250888/fpga2026-42161/doc/photous/动态，实物图.jpg

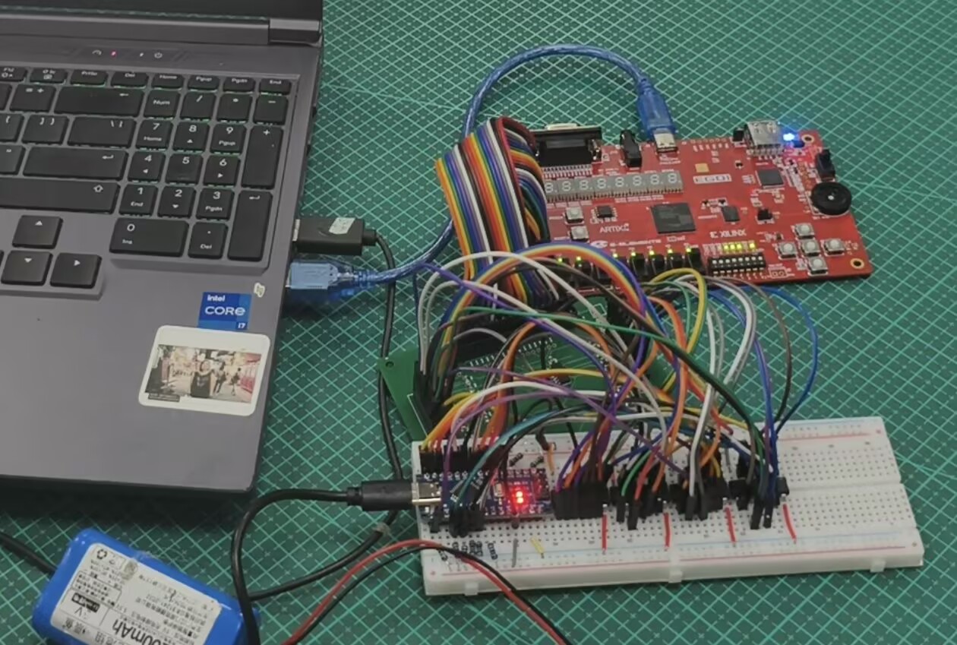
doc/photous/动态，实物图.jpg
