250888/fpga2026-42161/doc/photous/fpga.jpg

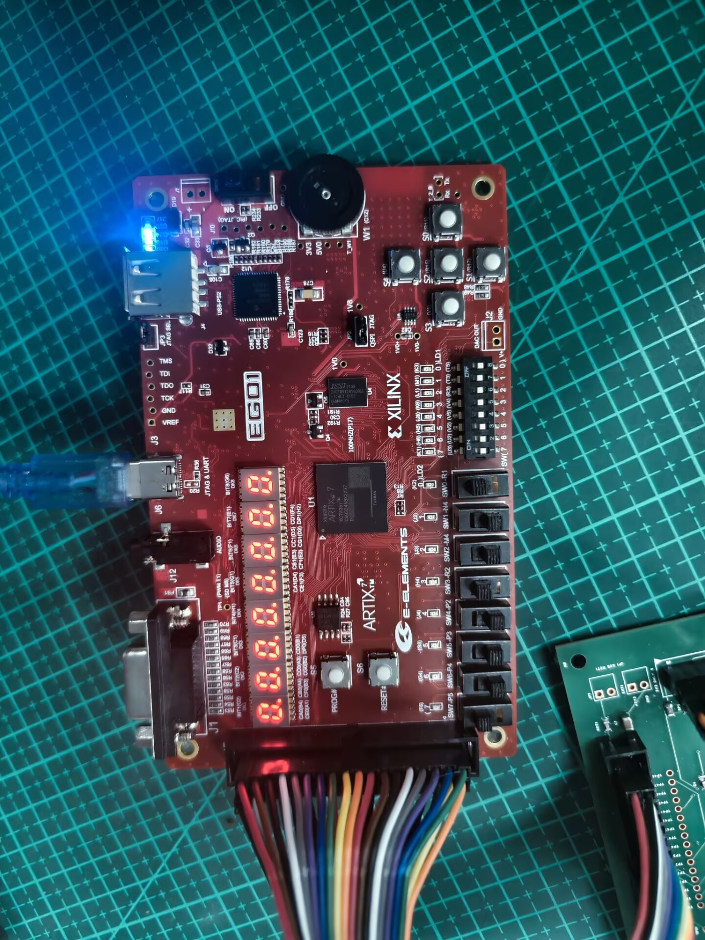
doc/photous/fpga.jpg
