250888/fpga2026-42161/doc/reports/2026-10-11-j5-pin-review/README.md

# J5 上板前逐针复核签字记录（§27-GO）

- **日期**：2026-10-11
- **结论：通过（GO）——四方 36/36 全一致，0 差异**
- **依据**：AGENTS §6 红线 6「上板前 J5 必须按 EGO1 V2.2 官方手册逐针复核（§27-GO），并留勾选记录」；
  用户已授权执行本复核（2026-10-11 拍板：「用它做 J5 上板前逐针复核签字」）。
- **复跑命令**：`D:/Embedded/Python/python.exe check_j5_pins.py`（本目录，需 python-docx + pypdf；
  任何一项不一致即退出码 1）。本次运行输出见 `check_output.txt`。

## 1. 四方基准

| # | 源 | 文件 | 权威性说明 |
|---|----|---|---|
| ① | **EGO1 V2.2 官方手册** | `资料/EGO1板卡/Ego1_UserManual_v2.2.pdf`（21 页，封面「2018.04 ver2.2 依元素科技」，J5 表在 p20–21） | 红线 6 指名基准；2026-10-11 经 ghfast.top 镜像自官方开发包公开副本归档 |
| ② | 南邮 eelab 转存件 | `资料/EGO1板卡/EGo1_用户手册_18页.pdf` + 同名全文提取 txt（J5 表 p17–18） | 网页转存（2018-09-18 打印），**无版本标记**；与 ① 逐项同，作交叉件 |
| ③ | V1.9 §4.1 表3 | `doc/瞬迹_完整可行技术路线_EGO1开发板版_V1.9.docx` tables[3] | 项目唯一技术基线（36 针全表） |
| ④ | 实施约束 | `constrs/ego1.xdc`（J5 段，行 30–67） | P0 按表3 重写的落地文件 |

## 2. 逐针勾选表（36/36 ✓，完整输出见 check_output.txt）

判定规则：1–32 针 = 四方 ball 全等 ∧ 两手册原理图标号相等 ∧ 表3「项目信号」含规定端口 ∧
XDC 端口/ball 对号（1–16→`a_ctrl_n[0..15]`，17–32→`b_raw[0..15]`）；
33–36 针 = 两手册与 XDC 均无此针 ∧ 表3 记 GND/3.3V。另查全文件无重复 `PACKAGE_PIN`。

| 针 | 原理图标号 | Ball | 端口 | ①V2.2 | ②南邮 | ③表3 | ④XDC | 勾选 |
|----|---|---|---|:---:|:-----:|:----:|:----:|:----:|
| 1 | AD2P_15 | B16 | a_ctrl_n[0] | ✓ | ✓ | ✓ | ✓ | ☑ |
| 2 | AD2N_15 | B17 | a_ctrl_n[1] | ✓ | ✓ | ✓ | ✓ | ☑ |
| 3 | AD10P_15 | A15 | a_ctrl_n[2] | ✓ | ✓ | ✓ | ✓ | ☑ |
| 4 | AD10N_15 | A16 | a_ctrl_n[3] | ✓ | ✓ | ✓ | ✓ | ☑ |
| 5 | AD3P_15 | A13 | a_ctrl_n[4] | ✓ | ✓ | ✓ | ✓ | ☑ |
| 6 | AD3N_15 | A14 | a_ctrl_n[5] | ✓ | ✓ | ✓ | ✓ | ☑ |
| 7 | AD11P_15 | B18 | a_ctrl_n[6] | ✓ | ✓ | ✓ | ✓ | ☑ |
| 8 | AD11N_15 | A18 | a_ctrl_n[7] | ✓ | ✓ | ✓ | ✓ | ☑ |
| 9 | AD9P_15 | F13 | a_ctrl_n[8] | ✓ | ✓ | ✓ | ✓ | ☑ |
| 10 | AD9N_15 | F14 | a_ctrl_n[9] | ✓ | ✓ | ✓ | ✓ | ☑ |
| 11 | AD8P_15 | B13 | a_ctrl_n[10] | ✓ | ✓ | ✓ | ✓ | ☑ |
| 12 | AD8N_15 | B14 | a_ctrl_n[11] | ✓ | ✓ | ✓ | ✓ | ☑ |
| 13 | AD0P_15 | D14 | a_ctrl_n[12] | ✓ | ✓ | ✓ | ✓ | ☑ |
| 14 | AD0N_15 | C14 | a_ctrl_n[13] | ✓ | ✓ | ✓ | ✓ | ☑ |
| 15 | IO_L4P | B11 | a_ctrl_n[14] | ✓ | ✓ | ✓ | ✓ | ☑ |
| 16 | IO_L4N | A11 | a_ctrl_n[15] | ✓ | ✓ | ✓ | ✓ | ☑ |
| 17 | IO_L11P | E15 | b_raw[0] | ✓ | ✓ | ✓ | ✓ | ☑ |
| 18 | IO_L11N | E16 | b_raw[1] | ✓ | ✓ | ✓ | ✓ | ☑ |
| 19 | IO_L12P | D15 | b_raw[2] | ✓ | ✓ | ✓ | ✓ | ☑ |
| 20 | IO_L12N | C15 | b_raw[3] | ✓ | ✓ | ✓ | ✓ | ☑ |
| 21 | IO_L13P | H16 | b_raw[4] | ✓ | ✓ | ✓ | ✓ | ☑ |
| 22 | IO_L13N | G16 | b_raw[5] | ✓ | ✓ | ✓ | ✓ | ☑ |
| 23 | IO_L14P | F15 | b_raw[6] | ✓ | ✓ | ✓ | ✓ | ☑ |
| 24 | IO_L14N | F16 | b_raw[7] | ✓ | ✓ | ✓ | ✓ | ☑ |
| 25 | IO_L15P | H14 | b_raw[8] | ✓ | ✓ | ✓ | ✓ | ☑ |
| 26 | IO_L15N | G14 | b_raw[9] | ✓ | ✓ | ✓ | ✓ | ☑ |
| 27 | IO_L16P | E17 | b_raw[10] | ✓ | ✓ | ✓ | ✓ | ☑ |
| 28 | IO_L16N | D17 | b_raw[11] | ✓ | ✓ | ✓ | ✓ | ☑ |
| 29 | IO_L17P | K13 | b_raw[12] | ✓ | ✓ | ✓ | ✓ | ☑ |
| 30 | IO_L17N | J13 | b_raw[13] | ✓ | ✓ | ✓ | ✓ | ☑ |
| 31 | IO_L18P | H17 | b_raw[14] | ✓ | ✓ | ✓ | ✓ | ☑ |
| 32 | IO_L18N | G17 | b_raw[15] | ✓ | ✓ | ✓ | ✓ | ☑ |
| 33 | GND | （电源针，不写 XDC） | — | — | — | ✓ | — | ☑ |
| 34 | GND | （电源针，不写 XDC） | — | — | — | ✓ | — | ☑ |
| 35 | 3.3V | （电源针，不写 XDC） | — | — | — | ✓ | — | ☑ |
| 36 | 3.3V | （电源针，不写 XDC） | — | — | — | ✓ | — | ☑ |

补充核对：`constrs/ego1.xdc` 全文件无重复 `PACKAGE_PIN`；行 115 的 `PACKAGE_PIN J5` 是
led[4] 的**封装球位**（Artix-7 球名恰为 J5），与 J5 连接器无关，不构成冲突。

## 3. 版本自证（原缺口① → 已闭环）

- 南邮转存件全文 0 处版本字样（18 页逐一检索 `V2.2/版本/revision/version` 无命中），
  第 1 页为网页版式「Docs » EGo1用户手册」，PDF 元数据 = 2018-09-18 浏览器打印——**该件本身无法自证版本**。
- 「EGO1 V2.2 用户手册」的**直接证据**（2026-10-11 检索）：
  1. 依元素官方文档站 <https://e-elements.readthedocs.io/zh/ego1_v2.2/>——路径 `ego1_v2.2`、
     标题「EGo1 2.2 文档」，源分支 `AJetfire/EES@EGo1_V2.2`（api.github.com 分支列表可见）；
  2. 官方开发包手册 PDF 封面逐字「EGO1 用户手册 / 2018.04 ver2.2 / 依元素科技有限公司」——
     已归档为本目录 §1 的源①（`Ego1_UserManual_v2.2.pdf`，21 页，WPS 原生 PDF，创建于 2018-07-02）。
- 交叉验证：v2.2 正式版 J5 表与南邮转存件 **32/32 逐项全同**（网络标号+封装球位），
  即此前基于南邮件的核对结论对 v2.2 同样成立；本记录的比对更以 v2.2 件**直接参与**四方比对。

## 4. 33–36 电源针佐证（原缺口② → 已闭环）

- 手册文字层只覆盖 1–32（v2.2 与南邮件均写「共提供 32 个双向 IO」，表止于 32）；
  全网检索亦无任何以文字写出「33/34=GND、35/36=3.3V」的公开正文。
- **原理图级证据**：官方开发包《EGO1電路圖.pdf》第 6 页（SHEET 6 OF 10，TITLE: IO，E-ELEMENTS）
  的 `J5 / 2X18P-B` 连接器：
  - pin 35（右上）与 pin 36（左上）→ 左右各一支 `+3.3V` 电源箭头；
  - pin 33（右二）与 pin 34（左二）→ 两侧竖轨下行汇合 → 标准接地符号；
  - pin 1–32 网络标号（AD2P_15…IO_L18N/P）与手册表逐项一致。
  该页已渲染放大目验（2026-10-11），PDF 已归档：`资料/EGO1板卡/EGO1电路图_官方开发包.pdf`。
- 故 V1.9 表3 的「33/34=GND、35/36=3.3V、备注不写 XDC」与 XDC 现状（无 33–36 条目）**成立**。

## 5. 遗留缺口（不阻塞本次 GO）

1. **依元素「EGo1-开发包 v1.61」需注册登录下载**（<http://www.e-elements.com/>，登录须本人操作）——
   当前证据链已由「官方文档站 + 官方开发包公开副本」闭合，此项降级为可选复核。
2. 手册文字层无 33–36 表述（以原理图级证据替代）；若需文字级，可在登录下载官方开发包后再核一次。

## 6. 签字栏

| 角色 | 结果 | 日期 | 签名 |
|---|---|---|---|
| 复核执行（AI 协作者，四方程序化比对 + 原理图目验） | GO | 2026-10-11 | （电子记录即本文件） |
| 用户确认（上板前最终签字） | 待签 | | |
