250888/fpga2026-42161/doc/实施计划.md

# 瞬迹 — 实施计划（阶段一启动）

> ⚠ 本文件依据旧版 V1.2；**决策以 `瞬迹_完整可行技术路线_EGO1开发板版_V1.9.docx` 为准**（见 `../AGENTS.md` §1）。  
> 日期：2026-09-14｜最近更新：2026-10-02（见文末重组记录）

## 三件事对照

| 项 | 内容 | 状态 |
|----|---|---|
| A | EGO1 Vivado 工程（xc7a35tcsg324-1，100MHz P17，J5 约束，UART T4/N5） | ✅ 综合/实现/bitstream 完成 |
| B | 下单物料（LVC07 / LVC14 / 4066 / 电阻电容 / IDC20 / 排线） | **待人工下单** |
| C | 4路 GPIO 自回环 RTL（拓扑扫描 + Timestamp + UART） | ✅ 仿真 PASS |

### 已完成（2026-09-14）

- 仿真：4 路交叉拓扑矩阵正确
- 比特流：`瞬迹/vivado/xj_top.bit`（LUT 149 / FF 197 / 时序收敛）
- XDC：部分无效 J5 管脚已修正；**上板前仍需对照 EGO1 手册核对**
- 注意：请在英文路径 `D:\xunjiji` 下跑 Vivado（中文路径会导致工具异常）

## 立刻要做

1. **官网报名**（截止 2026-09-22 24:00）— 最优先
2. **下单**第一批物料（见技术路线采购清单）
3. **对照 EGO1 V2.2 手册**核对 `constrs/ego1.xdc` 中 J5 引脚
4. 物料到货后：跳线 A0→B2, A1→B0, A2→B3, A3→B1，烧录 `xj_top.bit`
5. 串口 115200 抓 `A5 5A ...` 帧验证拓扑

## 阶段一验收标准

- [x] 仿真：4 路任意交叉，拓扑矩阵正确
- [ ] 上板：跳线 A0→B2, A1→B0, A2→B3, A3→B1
- [ ] UART 115200 收到 `A5 5A ...` 帧，矩阵与跳线一致
- [ ] 拔掉一根线：对应 open_flags 置位
- [ ] LED 指示扫描中 / 完成状态正确

## 阶段二预告

- 4 路静态故障注入（OPEN / MISWIRE）
- 前端 1 路物理链路（LVC07 + LVC14 + 上拉实验）
- 确认后再扩 16 路 PCB

## 风险

| 风险 | 处理 |
|---|---|
| J5 引脚表不准 | 上板前用手册/万用表核对；先只信 A[3:0]/B[3:0] |
| LVC14 反相 | RTL 侧已用「驱动低 → B 读低」约定；若实测反相，在 `input_sync` 后取反 |
| 报名未完成 | **最优先**，8 天内截止 |

---

## 重组记录（2026-10-02）

按用户指令完成项目清理与 uv 包化重组（原顶层工作区弃用，正式仓库 = 本目录）：

1. **结构**：RTL/TB 从 `src/` 提升到仓库根 `rtl/`、`sim/`；旧 Vivado 工程移入 `vivado/legacy/`；V1.9 基线、HANDOFF、抽取工具、阶段一报告归档进 `doc/`。
2. **uv 包**：`src/xunji`（`protocol.py` UART 帧 = V1.9 §17 冻结规格；`cli.py` = `xunji sync` 镜像构建目录），15 项 pytest **全绿**（TDD 红→绿）。
3. **规范**：新增根级 **`AGENTS.md`**（基于 superpowers 技能族：using-git-worktrees / writing-plans / executing-plans / TDD / systematic-debugging / verification-before-completion / finishing-a-development-branch / 评审技能）。
4. **Git**：本目录重新 `git init`，本地服务仓库 `git_server/`（remote=`origin`）。
5. 弃用旧目录移至 `../_archive_deprecated/`（保留不删除，附 README）。

**待办不变**：P0 —— EGO1 手册逐针复核表3 → 重写 XDC → 顶层 wrapper 对齐（见 `../README.md`）。
→ 代码侧已于 2026-10-08 完成，见下节；剩余为手册复核与板载 I/O 冻结决策。

---

## P0 记录（2026-10-08）

分支 `p0-xdc-wrappers`（worktree `.worktrees/p0-xdc-wrappers/`）；计划
`doc/superpowers/plans/2026-10-08-p0-xdc-wrappers.md`；TDD 红→绿，逐任务提交。

1. **XDC 重写**：`constrs/ego1.xdc` 冻结段 1–6 逐字对齐 V1.9 §4.2；J5 32 路针脚按
   §4.1 表3（废除旧草稿的 N18/L17 非法脚与试错脚）；`a_ctrl_n[*]` DRIVE 4 + SLEW SLOW；
   UART `uart_tx→T4`、`uart_rx→N5`；`create_clock -period 10.000`。
   板载 LED/按键/拨码为**暂定段**（V1.9 §4.2 未冻结 = HANDOFF §4.3 遗留1），待文档拍板。
   红线测试 `tests/test_xdc.py`（7 项，含全表无重复针）。
2. **顶层对齐**：`xunji_top_hw`（`b_conn=b_sync`，合成顶层）/ `xunji_top_loopback`
   （`b_conn=~b_sync`，仿真顶层，**全工程唯一反相点**）/ 共享 `xunji_core`（只读 `b_conn`，
   不再读 `b_raw`）。新增 `xj_rst_sync`（V1.9 §4.2 P030 原文实现）；`input_sync` 补
   `ASYNC_REG`/`SHREG_EXTRACT`；`topology_scanner` 去掉内部 `~b_filtered`。
   TB 改名 `tb_xunji_loopback` 并加极性交叉断言；红线测试 `tests/test_top.py`（8 项）。
3. **验证（本次会话实跑）**：`uv run pytest -q` → 41 passed；`uv run xunji lint` →
   两个顶层均 exit 0；`uv run xunji sim` → PASS（矩阵 = EXPECT）。
   变异检查：把 loopback 的 `~` 去掉 → sim 立刻 FAIL（exit 1），恢复后 PASS，证明断言真会咬。
   **`uv run xunji xsim` 阻塞**：本机 Vivado 2024.2 的 `xvlog.exe` 唯一缺失导入
   `xv_xsimverific.dll`（产品 `lib/win64.o` 载荷整体缺失），C:/D:/E: 全机无此文件也无安装包
   → 离线不可修，需重装或从完好机器拷 `Xilinx`。
4. **P0 仍未完成**：① EGO1 V2.2 手册 §14 逐针复核表3 并留勾选记录（工作区无手册 PDF）；
   ② 板载 LED/按键约束的冻结决策；③ `b_raw`→第一级同步器 D 端的 path exception
   （须 Vivado `report_cdc` 复核目标数 =16 后再写，宁可暂留未约束告警）。
5. **刻意不动**：`N_CH` 默认仍为 4（扩 16 路连同 P1 扫描重构与 TB 扩展一起做，避免
   未验证的行为变更）；`topology_scanner` 状态机/时序参数/矩阵位序不变；`uart_packet_tx`
   帧协议遗留不变。

## FE-16 PCB 记录（2026-10-12）

用户「开始画pcb」指定 V1.9 docx 方案，EDA 决策全权委托（四问确认：SOIC-14 / 全 0805 /
装 KiCad / 板框 160×90 四孔）。产出 `pcb/frontend16/`：

1. **流水线**：`run_pipeline.py` = gen_frontend16 → gen_dsn → Freerouting 2.5.0（JAR+JRE25
   绕行 native 启动 bug #957）→ route_ses → pytest(12)。最终 1437 段 / 154 过孔 / 84 网 / score 1000。
2. **净距线宽链**：Freerouting 拥塞走廊会把线收窄到 0.75/0.6/0.5 mm 阶梯（`automatic_neckdown`
   开关管不到的第三机制）→ route_ses 统一回写 0.25；DSN 规划净距取 0.27（0.2 要求 + 两侧各
   0.0626 半宽增量）保证抬宽后仍 ≥0.2；IDC/排针 pin1 独立方 padstack（方角比圆多伸 0.29mm，
   按圆建模会漏 shorting_items）。
3. **符号坐标**：KiCad 符号库 y 轴向上（渲染 y = Y − ly），lib 定义与标签表同步取负 y →
   引脚 1/VCC 顶置、GND 底置；连接器奇左偶右，符号行 = `pads_idc` 列对式排线物理列；
   连接器 pin name 隐藏（`~`）只留 number 避免与标签叠字；`_pin_abs` 负责标签落点跟随。
4. **验证（会话实跑）**：kicad-cli 10.0.7 DRC 0 / ERC 0（`xunji_fe16.kicad_pro` 仅
   lib_* / endpoint_off_grid 三类 ignore，真问题保持报错）；`uv run pytest -q` 61 passed；
   PCB 输出哈希验证为确定性，符号改动零影响布线（前后字节一致）。三视图目检 `doc/FE16预览.html`。
5. **提交**：1ab55a3（全套）+ fc083de（预览页/SVG），未推送（推送待用户拍板）。
   遗留：spec D10 线宽/铺铜与 JP1 脚数两处文档回填；`demo_*.rpt` 工作树残留未删。

## FE-16 改板 96×96 记录（2026-10-13）

用户「要直接能打板的最终 pcb，最好 <10×10cm，嘉立创可用免费券」→ 板框 160×90 → **96×96 mm**。
网表/位号/BOM 不变，仅几何重排：J5 顶中 (26.4,6.5)、JB 镜像 x=85.73、IC 以 x=48 对称、
电源区挪 J5 右侧顶角 (77/84, 6.5..13.5)、RP 列 x=77.5、TP 行 y=77/83/17、四角 φ3.2 随板框。
改动面：`fe16_design.py` / `gen_frontend16.py` / `fe16_router.py` / `gen_dsn.py`（boundary 动态）/
`tests/test_frontend_pcb.py`（分区断言改相对坐标）。

1. **丝印修复**：TP1..16 位号下置（+2）——上置会探进 C3/C6 焊盘/丝印（silk_over_copper/
   silk_overlap 各 4 条 warning），下置后 --severity-all 0 violation。
2. **复跑管线**：freerouting 0 unrouted 0 violations → 1903 段 / 164 过孔 / 84 网（回填加宽 114 处）；
   pytest 12 passed；kicad-cli DRC --severity-all **0 violation / 0 未连接**。
3. **交付**：`xunji_fe16_gerber_96x96.zip`（F/B Cu+Mask+Silk+Paste、Edge.Cuts、job、Excellon
   mm 钻孔 0.3/1.0/3.2 三孔径，共 11 文件），嘉立创直接上传；下单留用户拍板。
4. LCEDA 云端路径弃用：保存零流量、重载树空 boards=[]，定性不可用。

## P1 静态核心 T1：四阶段扫描（2026-10-22）

分支 `p1-static-core`（worktree `.worktrees/p1-static-core/`，基线 `686848b`）；计划
`doc/superpowers/plans/2026-10-22-p1-static-core.md`。TDD：TB 先红（`parameter GUARD_STABLE not found`）→ 实现 → 绿。

1. **FSM（`rtl/topology_scanner.v`，= V1.9 R6 static_sampler）**：IDLE → IDLE_CHECK → 每通道
   DRIVE → SETTLE(500) → SAMPLE(101 拍逐位计票) → DECIDE（票数 > 50 且非卡低才判连接）→
   RELEASE/GUARD（b_conn 全 0 连续 8 拍；500 拍超时置 release_timeout）→ NEXT ×N_CH → DONE（算 open_flags）。
   新增输出 `stuck_low_mask` / `idle_ok` / `release_timeout`；IDLE_CHECK 若有通道为 1，
   只记 mask 并在矩阵中强制该列为 0（V1.9「禁止当成正常连接边」）。
2. **TB（`sim/tb_static_sampler.v`）**：参数取小值加速，四场景 —— 正常交叉矩阵（位序 = V1.9 P059）、
   采样窗内 1 拍毛刺免疫、空闲卡低（mask=1000/idle_ok=0/该列强制 0）、释放后卡高（release_timeout=1）。
3. **接线**：`xunji_core` 接新输出并重排 LED 语义（[3]idle_ok [4]release_timeout [5]卡低 [6]任一开口）。
   **N_CH 保持 4**：uart_packet_tx 仍是 4×4/4B 载荷，4→16 必须与 §17 载荷扩展同批（T2/T3）。
4. **验证（本次实跑）**：pytest **66 passed**；lint 双顶层 exit 0；sim 三 TB PASS；
   xsim 2026.1 终审三 TB PASS。红线测试 `tests/test_static_sampler.py`（默认参数/阶段/输出/多数表决/注册 5 项）。
5. 调试插曲：`S_DONE = 3'd8` 被截断为 0（状态 4 位）导致 done 永不发；TB start 单拍与 DUT 采样竞争
   → 改 `4'd8` 与 start 保持 3 拍。

## P1 静态核心 T2：Golden Map 比较与 LEARN（2026-10-22）

1. **`rtl/matrix_degree.v`**：逐行/列统计连接度，输出 `a_eq1/a_gt1/a_zero`、`b_eq1/b_gt1/b_zero`
   与 `all_one`（全行列度均为 1），供 golden_compare 与 learn_gate 共用。
2. **`rtl/golden_compare.v`（V1.9 P060）**：`missing=M_ref&~M_test`、`extra=~M_ref&M_test`；
   分类优先级 PASS → BRIDGE（任一 deg>1）→ MISWIRE（缺失+额外并存且参考有效行/列实测度仍为 1，
   即双射换位，不限于两根互换）→ OPEN（只有缺失、缺失行实测全空）→ ANOMALY（其余混合）。
3. **`rtl/learn_gate.v`（V1.9 P059）**：LEARN 仅当 `idle_ok && all_one` 才写入 M_ref 并置
   `reference_valid=1`；否则拒绝（valid=0，M_ref 保持不变），避免学到坏参考。
4. **TB（`sim/tb_golden_compare.v`）**：PASS/OPEN/MISWIRE/BRIDGE/ANOMALY 五向量 + LEARN 接受/
   IDLE 拒绝/度非 1 拒绝三路径；分类枚举与 TB `C_*` 常量对齐。
5. **调试插曲**：xsim 下 TB 与 DUT 同 delta 更新 `m_scan`/`learn`，组合度标记未结算 → BRIDGE 被误接受；
   TB 在拉 learn 前加 1 ns 结算（硬件语义：矩阵稳定后才按 LEARN），iverilog 未暴露。清单测试改为
   「SIM_TOPS = sim/ 下全部 tb_*」自维护。
6. **验证（本次实跑）**：pytest **70 passed**；lint 双顶层 exit 0；sim 四 TB PASS；xsim 终审四 TB PASS。

## P1 静态核心 T3：16 路 + 拓扑帧载荷扩展（2026-10-22）

1. **文档定性**：V1.9 §17（P106）只冻结帧结构（SOF 55AA/Ver/Type/Len/Seq/Payload/CRC16，小端、CRC 参数），
   **payload 语义是工程决策**（原 4B 布局亦如此）。故本次不改 V1.9 docx，改为决策记录
   `doc/superpowers/specs/2026-10-22-topology-frame-16ch.md` 并经 protocol/TB 双向锁定。
2. **新 payload**：`MAT(N*N/8) + open(2,LE) + stuck(2,LE) + cls(1) + ts0(1)`；4 路 8B/帧 18B，
   16 路 38B/帧 48B；Type=1 与 CRC 不变；byte k = `matrix[8k+7:8k]`（与旧 mat_lo/mat_hi 顺序兼容）。
   cls：0 PASS / 1 OPEN / 2 MISWIRE / 3 BRIDGE / 4 ANOMALY / 5 NO_REF（未学习）。
3. **RTL**：`uart_packet_tx` 重写为 N_CH 通用（MAT_BYTES/PAYLOAD_LEN/BODY_LEN/FRAME_LEN 由 N_CH 推导，
   matrix 由逐字节 part-select 取），新增 `stuck_low_mask`/`cls` 输入；`xunji_core` 与双 wrapper 默认 N_CH=16；
   core 暂以 `cls=5`（NO_REF）上报，T4 接 golden_compare 后替换。
4. **验证**：pytest **75 passed**（新增 test_matrix_payload 5 项 + 黄金帧更新）；lint 双顶层 exit 0；
   sim 四 TB PASS（tb_uart_packet_tx 改 18B×2 帧线级解码 + 独立 CRC 复算）。
5. **环境阻塞（非代码）**：xsim 不可用 —— 应用控制策略拦截 xelab 生成的 `xsimk.exe`
   （`D:\xunjiji` / `C:\xjbuild` / `E:\d` 三处实测均「应用程序控制策略已阻止此文件」）。
   T1/T2 的 xsim 证据在该策略生效前已取得；本任务以 lint+iverilog 四 TB 收口，终审待策略放行后补跑。

## P1 静态核心 T4：core 集成 + 16 路综合（2026-10-22）

1. **core 接线**：实例化 `learn_gate`（`btn[1]` 上升沿 → `learn_pulse`，按住不重复学习）与
   `golden_compare`（`m_test=conn_matrix`、`m_ref=learn 输出`）；帧内 `cls = reference_valid ? cmp_cls : 5`，
   未学习上报 NO_REF，不伪装 PASS；LED[7] = reference_valid（已学习指示）。
2. **集成 TB（`sim/tb_static_cls.v`）**：正常线束扫描 → 按 LEARN 接受参考 → 切双射换位/开路/双连
   三种故障重扫 → 分别期望 MISWIRE/OPEN/BRIDGE → 回正常期望 PASS。
3. **lint**：learn_gate 只消费 `matrix_degree.all_one`，逐行/列明细输出按接口留白豁免。
4. **验证（2026-10-24 实跑）**：pytest **84 passed**；lint 双顶层 exit 0；iverilog **6 TB** PASS
   （新增 16 路 48B 帧 TB，含"发送中途改矩阵"快照回归；`xunji sim` 现返回 0）。
5. **16 路综合/实现（工作流 A，C:\xjbuild）**：bit 产出 **2,192,215 B**；
   LUT **2119 (10.19%)**、FF **1564 (3.76%)**、BRAM 0、DSP 0（**不含 ILA**）；
   WNS **+1.408 ns**、WHS +0.029 ns，**全部时序约束 met**。
   （注：旧记录的 LUT 173 / FF 240 / WNS +4.765 是 4 路版数字，已作废。）
6. **未完成**：xsim 终审（策略阻塞）；上板 4 路回环 → FE-16 16 路联调；报告 §27 GO 表回填。
