250888/fpga2026-42161/doc/superpowers/plans/2026-10-11-uart-frame-v19.md

# 计划：uart_packet_tx 帧协议对齐 V1.9 §17

> 日期：2026-10-11 ｜ 分支：`uart-frame-v19` ｜ 基线：main@24532b8（四层全绿）
> 触发：用户拍板「uart_packet_tx 帧协议 A5 5A/CRC8 需对齐 V1.9 §17 的 55 AA/CRC-16」。

## 目标与规格（冻结自 V1.9 §17，只对齐、不扩展）

帧布局（除 SOF 外多字节一律小端）：

```
SOF(55 AA) | Version(1B) | Type(1B) | Length(2B) | Sequence(2B) | Payload | CRC(2B)
```

- CRC = **CRC-16/CCITT-FALSE**：poly=0x1021、init=0xFFFF、refin=false、refout=false、xorout=0x0000；
  覆盖 **Version..Payload**（不含 SOF 与 CRC 自身），结果小端存放（低字节先发）。
- 主机侧 `src/xunji/protocol.py` 已是 §17 参考实现（`test_protocol.py` 9 项已锁公开校验值 0x29B1），
  **本次只改 RTL 侧与验证设施**，Python 是 golden 来源。

### RTL 帧字段决策（§17 未枚举的部分，本计划固定）

| 字段 | 取值 | 依据 |
|---|---|---|
| Version | `8'd1` | 协议首版；`protocol.py` 测试样例同为 1 |
| Type | `8'd1`（拓扑矩阵帧） | §17 只给格式未枚举 Type 表；定为 1 并在 `protocol.py` 增加命名常量 `TYPE_MATRIX=1` 锁定 |
| Length | `16'd4`（LE：`04 00`） | Payload 语义不变：mat_lo、mat_hi、open、ts0（演示级 4 路） |
| Sequence | 16 位自由运行计数器，复位=0，首帧发 0，每帧 +1（mod 65536） | §17 用 Sequence/Chunk 重组；单帧单调即可 |
| Payload | `matrix[7:0], matrix[15:8], {4'b0,open_flags}, timestamp[7:0]` | 与旧帧语义一致（本次只换封装，不动载荷） |

总帧长 = 2+1+1+2+2+4+2 = **14 B**。

### 黄金向量（Python `build_frame` 生成，写入 TB 与 pytest 双向锁定）

激励：`matrix=16'h2804`（loopback PASS 矩阵）、`open_flags=0`、`timestamp=64'hDEADBEEFCAFEBABE`（取 ts0=BE）：

| seq | 帧（hex） |
|-----|---|
| 0 | `55AA010104000000042800BEB1C9` |
| 1 | `55AA010104000100042800BE118C` |

## 架构

`rtl/uart_packet_tx.v` 重写为三态 FSM（100 MHz 单时钟，无新逻辑时钟）：

1. **S_IDLE**：`trigger && !sending` → 锁存 mat_lo/mat_hi/open/ts0、`frame_seq<=seq_q`、`seq_q<=seq_q+1`、`crc_r<=16'hFFFF` → S_PREP。
2. **S_PREP**：10 拍，每拍对 1 个 body 字节做 `crc16_update`（body = Ver..ts0）；pidx 9 拍后 → S_SEND。
   逐字节分开算，避免单拍 80 次串行迭代的组合深度。
3. **S_SEND**：`!tx_busy` 时逐字节发 14 B：`55,AA,Ver,Type,Len_lo,Len_hi,Seq_lo,Seq_hi,payload×4,crc_lo,crc_hi` → S_IDLE。

CRC 函数用与 Python 逐行同构的 xor-first 形式（`c = crc_in ^ {data,8'h00}` 后 8 次左移+条件异或 0x1021），
该形式与移位注入式在整字节后等价，直接消除 PC/RTL 理解偏差（§17 明文要求）。

握手保持既有 `tx_start` 单拍脉冲 + `tx_busy` 回压约定，`xunji_core` 接线不动。

## 测试策略（TDD：红在前）

新增 `sim/tb_uart_packet_tx.v`（自带 UART 收字节模型，不依赖 uart_tx）：

- 第 1 帧核对黄金向量 seq0 全 14 B；第 2 帧核对 seq 递增（黄金向量 seq1）；
- TB 内部另置独立实现的 CRC-16 函数复算 CRC（双重防线）；
- 输出整行 `PASS` / `FAIL ...` + `$fatal`，匹配 G2 判定。

`src/xunji/cli.py`：`SIM_TOP` → `SIM_TOPS = ("tb_xunji_loopback", "tb_uart_packet_tx")`，
sim 层对每个 top 编译-运行-判 G2，xsim 层 xvlog 一次 + 每 top 各跑一轮 xelab/xsim，全过才 0。

## 任务清单（每步验证命令 + 单独提交）

| # | 任务 | 文件 | 验证命令（预期） |
|---|---|---|---|
| 1 | 红线测试先行：RTL 源码红线 + TB 黄金帧与 protocol.py 双向锁定 + protocol 增加 `TYPE_MATRIX` 常量 | `tests/test_uart_packet_tx.py`（新增）、`src/xunji/protocol.py`（加常量） | `uv run pytest -q` → 新测试**失败**（RTL 仍是 A5 5A、TB 不存在），旧 41 项仍绿 |
| 2 | 专用 TB + CLI 双 top 接入 | `sim/tb_uart_packet_tx.v`（新增）、`src/xunji/cli.py` | `uv run xunji sim` → **FAIL**（旧 RTL 发 A5 5A，TB 判帧头错） |
| 3 | RTL 重写对齐 §17 | `rtl/uart_packet_tx.v` | `uv run xunji sim` → **PASS**；`uv run pytest -q` → 全绿 |
| 4 | 四层终验 + 文档回写（HANDOFF 三问答案、变更记录） | `doc/HANDOFF_AI.md` | `uv run pytest -q` 41+2 项绿、`uv run xunji lint` exit 0、`uv run xunji sim` PASS、`uv run xunji xsim` PASS |

### 任务 5（合并前 code review 追加，2026-10-11）

评审（BASE 24532b8 → HEAD 55e6fda）判 **REQUEST CHANGES**：1 blocker + 2 minor + 4 nit。

| # | 任务 | 文件 | 验证命令（预期） |
|---|---|---|---|
| 5a | 红：TB 从行为级 busy 模型改为真实 `uart_tx` + `tx` 线 8N1 中点采样解码（复现 blocker：停止位截断）；minor-2 SIM_TOPS 精确解析、nit-4/5 红线归一加固 | `sim/tb_uart_packet_tx.v`、`tests/test_uart_packet_tx.py` | `uv run xunji sim` → **FAIL framing byte[0]**（停止位中点采低）；pytest 49 绿 |
| 5b | 修复：`uart_tx` 的 `tx_busy` 覆盖完整停止位（新增 `bit_pos=10` 完结拍）；nit-7 sim/xsim 分 top 标签；nit-6 撤销过期 BLKSEQ 豁免 | `rtl/uart_tx.v`、`src/xunji/cli.py`、`scripts/lint.vlt` | 四层全绿（pytest 49 / lint 0 / sim 双 PASS / xsim 双 PASS） |
| 5c | 文档：本节 + HANDOFF 变更记录补记（blocker 根因与修复） | 计划、`doc/HANDOFF_AI.md` | 提交前四层复跑 |

**Blocker 根因**：`uart_tx` 旧实现在停止位**开始**沿即清 `tx_busy`（busy 只覆盖起始位+8 数据位），
上层在其后 3 拍即可发下一字节 → 背靠背字节的停止位被截成 30 ns（115200 需 8.68 µs），
标准 8N1 接收机在停止位中点采到低电平 framing error。原三层验证均不解码 `tx` 线，故全绿但不端到端。
修法归属 `uart_tx`（线时序是它的职责）：`bit_pos=9` 停止位开始不降 busy，`bit_pos=10` 满 1 bit 才降。

红线（不可违）：仅 100 MHz 单时钟 + clock-enable 节拍；不改 `xunji_core` 接口与载荷语义；
不碰 XDC/极性；提交信息 Conventional Commits、正文中文。

## 收尾

按 AGENTS §3.6：全绿后给用户三选项（合并/PR/保留）；上轮用户已选过"合并回 main 并推 git_server"，
但对外推送仍需用户逐次拍板，不预设。
