250888/fpga2026-42161/doc/瞬迹_完整可行技术路线_EGO1开发板版_V1.9.docx

瞬迹

基于 FPGA 并行时序分析的线束拓扑重建与动态互连瞬态诊断系统

完整可行技术路线｜采购—原型—16路系统—实验验证

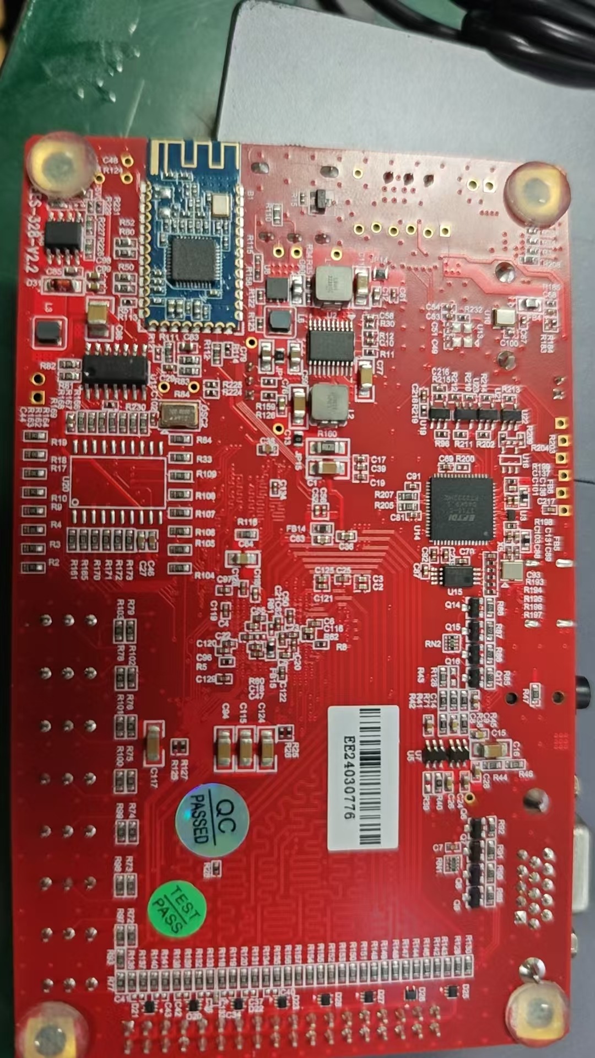
[picture p16: figure]
EGO1 Artix-7 XC7A35T开发板元器件面实物照片

主控平台：EGO1 Artix-7 FPGA开发板（搭载 XC7A35T-1CSG324C）｜100 MHz系统时钟

版本：V1.9（最终开工前严格审计版）｜45天实施范围

# 1. 项目定位与最终目标

核心定位

本项目不是普通“通断测试仪”。静态阶段重建线束连接关系并发现断路、短路、错接；动态阶段利用 FPGA 的多通道并行硬件和统一时基，捕获弯折、振动、松动过程中难以复现的微秒级间歇开路与接触抖动，并保留故障前后波形与事件时间序列。

一句话主线：静态重建“线怎么接”，动态捕获“线什么时候断”。

45天内第一版严格限定为16芯、无源、低压、点到点线束；正常参考拓扑限定为“一对一连接”，但允许任意针脚排列/交叉映射。多分支、多点并联等本来就存在一对多连接的特殊线束不纳入第一版正常工况，否则会与桥接故障判定发生语义冲突。先把多通道并行捕获、确定性时间戳和动态微瞬态做深，再考虑特殊拓扑、接触电阻和动态短路编码检测。

# 2. 45天版本功能边界

功能 | 第一版定义 | 优先级
16路自动拓扑识别 | 点到点一对一线束：A1～A16自动匹配B1～B16，允许任意排列 | 必须
静态断路检测 | 定位具体开路针脚 | 必须
静态短路/桥接检测 | 在一对一参考拓扑下识别额外多连接/桥接异常 | 必须
静态错接检测 | 输出 Expected / Actual | 必须
动态间歇开路 | 目标推进至 μs 级，最终指标以实测为准 | 核心
接触抖动 | 记录短时间内重复通断次数和脉宽 | 核心
统一硬件时间戳 | 所有通道共享 FPGA 时基 | 核心
Pre-trigger 黑匣子 | 保存故障前/后逻辑波形 | 必须
多事件时序关联 | 给出不同通道事件时间先后与间隔 | 加分
上位机 | 拓扑图、逻辑波形、事件统计 | 必须
动态瞬态短路 | 编码模式检测 | 完成核心后再做
接触电阻精密测量/AI预测/APP | 不纳入第一版 | 暂缓

# 3. 总体系统架构

┌──────────── FPGA ────────────┐
A端16路 → 激励前端 → 拓扑扫描/驱动控制 │
│ ↓ │
B端16路 → 整形前端 → 输入同步 → 连接矩阵重建 │
│ ↓ │
│ Golden Map 比较 │
│ OPEN/BRIDGE/MISWIRE │
│ │
│ 16路并行 Event Detector │
│ ↓ 统一 Timestamp │
│ Event FIFO / 时序关联 │
│ ↓ │
│ Pre-trigger BRAM Buffer │
└──────────┬───────────────────┘
│ UART/USB
↓
PC 可视化与数据保存

系统分工原则：PC 只负责显示、保存、报告生成；拓扑重建、故障分类、动态事件检测、时间戳、触发和缓存全部由 FPGA 完成。这样才能保证 FPGA 是系统主体，而不是“采集卡”。

# 4. 已确认主控平台：EGO1 Artix-7 FPGA开发板

主控板已确认就是 EGO1 Artix-7 FPGA开发板，板上搭载 Xilinx Artix-7 XC7A35T-1CSG324C FPGA。这里的“EGO1”是开发板型号，“XC7A35T”是这块开发板上的FPGA器件型号，并不是两块板或两个独立平台。该FPGA属于 AMD/Xilinx 7 Series，符合本赛道器件范围。后续硬件接口、时钟与资源预算均直接以这块 EGO1 开发板为基准。

- FPGA资源：XC7A35T 具有 33,280 个逻辑单元、20,800 个6输入LUT、41,600个触发器、90个DSP48E1，以及1,800 Kb片上Block RAM。16路拓扑扫描、并行Event Detector、64位全局时间戳、Event FIFO与Pre-trigger缓存均在资源能力范围内。
- 系统时钟：EGO1 板载 100 MHz 时钟，SYS_CLK 直接接入 FPGA P17。第一版直接以100 MHz作为统一硬件时基，计数颗粒为10 ns；10 ns仅代表数字时基颗粒，不能等同于整机最终测量精度。
- 扩展接口：EGO1 的 J5 是 2×18（36针）连接器，其中物理针1～32为32个双向扩展I/O，33/34为GND，35/36为3.3V。第一版采用32路直连：J5物理针1～16固定为A1～A16控制端 a_ctrl_n[15:0]，17～32固定为B1～B16检测端 b_raw[15:0]；33～36只作为地/电源。A端语义统一为 a_ctrl_n=0 表示LVC07拉低线束，a_ctrl_n=1 表示释放（高阻）。XDC、36针转接线、前端PCB丝印和RTL编号必须一一对应。
- PC通信：EGO1 已板载 USB-UART/JTAG，因此不再采购CP2102/CH340。按EGO1 V2.2手册，板级网络名 UART_RX 对应 FPGA Pkg Pin T4（从FPGA视角是发送TX），板级网络名 UART_TX 对应 N5（从FPGA视角是接收RX）。本项目顶层端口统一按FPGA视角命名：uart_tx→T4，uart_rx→N5，避免把板级网络名与RTL方向混淆。板载2 Mbit异步SRAM只作为后续长窗口扩展，第一版优先使用片上BRAM。

## 4.1 J5物理针—FPGA封装脚—项目信号固定映射

从本版本开始，J5不再采用“根据Vivado DRC试错换脚”的方式。以下映射固定以 EGO1 V2.2 用户手册第14节“通用扩展I/O”为依据：J5物理针1～16固定分配给A端激励，17～32固定分配给B端检测；33/34为GND，35/36为3.3V，不进入XDC逻辑端口。前端PCB丝印、36芯转接线、RTL端口编号和XDC必须全部按此表保持一致。

J5物理针 | 项目信号 | EGO1原理图标号 | FPGA PACKAGE_PIN | 备注
1 | A1 / a_ctrl_n[0] | AD2P_15 | B16 | FPGA输出→LVC07；0=拉低，1=释放；LVCMOS33
2 | A2 / a_ctrl_n[1] | AD2N_15 | B17 | FPGA输出→LVC07；0=拉低，1=释放；LVCMOS33
3 | A3 / a_ctrl_n[2] | AD10P_15 | A15 | FPGA输出→LVC07；0=拉低，1=释放；LVCMOS33
4 | A4 / a_ctrl_n[3] | AD10N_15 | A16 | FPGA输出→LVC07；0=拉低，1=释放；LVCMOS33
5 | A5 / a_ctrl_n[4] | AD3P_15 | A13 | FPGA输出→LVC07；0=拉低，1=释放；LVCMOS33
6 | A6 / a_ctrl_n[5] | AD3N_15 | A14 | FPGA输出→LVC07；0=拉低，1=释放；LVCMOS33
7 | A7 / a_ctrl_n[6] | AD11P_15 | B18 | FPGA输出→LVC07；0=拉低，1=释放；LVCMOS33
8 | A8 / a_ctrl_n[7] | AD11N_15 | A18 | FPGA输出→LVC07；0=拉低，1=释放；LVCMOS33
9 | A9 / a_ctrl_n[8] | AD9P_15 | F13 | FPGA输出→LVC07；0=拉低，1=释放；LVCMOS33
10 | A10 / a_ctrl_n[9] | AD9N_15 | F14 | FPGA输出→LVC07；0=拉低，1=释放；LVCMOS33
11 | A11 / a_ctrl_n[10] | AD8P_15 | B13 | FPGA输出→LVC07；0=拉低，1=释放；LVCMOS33
12 | A12 / a_ctrl_n[11] | AD8N_15 | B14 | FPGA输出→LVC07；0=拉低，1=释放；LVCMOS33
13 | A13 / a_ctrl_n[12] | AD0P_15 | D14 | FPGA输出→LVC07；0=拉低，1=释放；LVCMOS33
14 | A14 / a_ctrl_n[13] | AD0N_15 | C14 | FPGA输出→LVC07；0=拉低，1=释放；LVCMOS33
15 | A15 / a_ctrl_n[14] | IO_L4P | B11 | FPGA输出→LVC07；0=拉低，1=释放；LVCMOS33
16 | A16 / a_ctrl_n[15] | IO_L4N | A11 | FPGA输出→LVC07；0=拉低，1=释放；LVCMOS33
17 | B1 / b_raw[0] | IO_L11P | E15 | LVC14输出 → FPGA输入；LVCMOS33
18 | B2 / b_raw[1] | IO_L11N | E16 | LVC14输出 → FPGA输入；LVCMOS33
19 | B3 / b_raw[2] | IO_L12P | D15 | LVC14输出 → FPGA输入；LVCMOS33
20 | B4 / b_raw[3] | IO_L12N | C15 | LVC14输出 → FPGA输入；LVCMOS33
21 | B5 / b_raw[4] | IO_L13P | H16 | LVC14输出 → FPGA输入；LVCMOS33
22 | B6 / b_raw[5] | IO_L13N | G16 | LVC14输出 → FPGA输入；LVCMOS33
23 | B7 / b_raw[6] | IO_L14P | F15 | LVC14输出 → FPGA输入；LVCMOS33
24 | B8 / b_raw[7] | IO_L14N | F16 | LVC14输出 → FPGA输入；LVCMOS33
25 | B9 / b_raw[8] | IO_L15P | H14 | LVC14输出 → FPGA输入；LVCMOS33
26 | B10 / b_raw[9] | IO_L15N | G14 | LVC14输出 → FPGA输入；LVCMOS33
27 | B11 / b_raw[10] | IO_L16P | E17 | LVC14输出 → FPGA输入；LVCMOS33
28 | B12 / b_raw[11] | IO_L16N | D17 | LVC14输出 → FPGA输入；LVCMOS33
29 | B13 / b_raw[12] | IO_L17P | K13 | LVC14输出 → FPGA输入；LVCMOS33
30 | B14 / b_raw[13] | IO_L17N | J13 | LVC14输出 → FPGA输入；LVCMOS33
31 | B15 / b_raw[14] | IO_L18P | H17 | LVC14输出 → FPGA输入；LVCMOS33
32 | B16 / b_raw[15] | IO_L18N | G17 | LVC14输出 → FPGA输入；LVCMOS33
33 | GND | GND | — | 电源地；不写XDC
34 | GND | GND | — | 电源地；不写XDC
35 | 3.3V | 3.3V | — | 前端3.3V；不写XDC
36 | 3.3V | 3.3V | — | 前端3.3V；不写XDC

依据：EGO1 V2.2 用户手册，第14节“通用扩展I/O”。上板约束以该表为唯一针脚基准；若RTL端口名调整，只改 get_ports 名称，不改变 PACKAGE_PIN。

## 4.2 ego1.xdc 基线约束（对应上表）

以下约束用于当前16路A端激励 + 16路B端检测方案。端口名采用 a_ctrl_n[15:0] 与 b_raw[15:0]；如果工程中的顶层端口名不同，只修改 get_ports 中的名称。不得再通过“DRC失败后换一个能过的封装脚”来修约束。

set_property -dict { PACKAGE_PIN P17 IOSTANDARD LVCMOS33 } [get_ports {sys_clk}] # 100 MHz
create_clock -add -name sys_clk_pin -period 10.000 -waveform {0 5.000} [get_ports {sys_clk}]

# EGO1 S6逻辑复位按键：P15，按下拉低；RTL端口采用rst_n
set_property -dict { PACKAGE_PIN P15 IOSTANDARD LVCMOS33 } [get_ports {rst_n}]

set_property -dict { PACKAGE_PIN B16 IOSTANDARD LVCMOS33 } [get_ports {a_ctrl_n[0]}] # J5-1
set_property -dict { PACKAGE_PIN B17 IOSTANDARD LVCMOS33 } [get_ports {a_ctrl_n[1]}] # J5-2
set_property -dict { PACKAGE_PIN A15 IOSTANDARD LVCMOS33 } [get_ports {a_ctrl_n[2]}] # J5-3
set_property -dict { PACKAGE_PIN A16 IOSTANDARD LVCMOS33 } [get_ports {a_ctrl_n[3]}] # J5-4
set_property -dict { PACKAGE_PIN A13 IOSTANDARD LVCMOS33 } [get_ports {a_ctrl_n[4]}] # J5-5
set_property -dict { PACKAGE_PIN A14 IOSTANDARD LVCMOS33 } [get_ports {a_ctrl_n[5]}] # J5-6
set_property -dict { PACKAGE_PIN B18 IOSTANDARD LVCMOS33 } [get_ports {a_ctrl_n[6]}] # J5-7
set_property -dict { PACKAGE_PIN A18 IOSTANDARD LVCMOS33 } [get_ports {a_ctrl_n[7]}] # J5-8
set_property -dict { PACKAGE_PIN F13 IOSTANDARD LVCMOS33 } [get_ports {a_ctrl_n[8]}] # J5-9
set_property -dict { PACKAGE_PIN F14 IOSTANDARD LVCMOS33 } [get_ports {a_ctrl_n[9]}] # J5-10
set_property -dict { PACKAGE_PIN B13 IOSTANDARD LVCMOS33 } [get_ports {a_ctrl_n[10]}] # J5-11
set_property -dict { PACKAGE_PIN B14 IOSTANDARD LVCMOS33 } [get_ports {a_ctrl_n[11]}] # J5-12
set_property -dict { PACKAGE_PIN D14 IOSTANDARD LVCMOS33 } [get_ports {a_ctrl_n[12]}] # J5-13
set_property -dict { PACKAGE_PIN C14 IOSTANDARD LVCMOS33 } [get_ports {a_ctrl_n[13]}] # J5-14
set_property -dict { PACKAGE_PIN B11 IOSTANDARD LVCMOS33 } [get_ports {a_ctrl_n[14]}] # J5-15
set_property -dict { PACKAGE_PIN A11 IOSTANDARD LVCMOS33 } [get_ports {a_ctrl_n[15]}] # J5-16

set_property -dict { PACKAGE_PIN E15 IOSTANDARD LVCMOS33 } [get_ports {b_raw[0]}] # J5-17
set_property -dict { PACKAGE_PIN E16 IOSTANDARD LVCMOS33 } [get_ports {b_raw[1]}] # J5-18
set_property -dict { PACKAGE_PIN D15 IOSTANDARD LVCMOS33 } [get_ports {b_raw[2]}] # J5-19
set_property -dict { PACKAGE_PIN C15 IOSTANDARD LVCMOS33 } [get_ports {b_raw[3]}] # J5-20
set_property -dict { PACKAGE_PIN H16 IOSTANDARD LVCMOS33 } [get_ports {b_raw[4]}] # J5-21
set_property -dict { PACKAGE_PIN G16 IOSTANDARD LVCMOS33 } [get_ports {b_raw[5]}] # J5-22
set_property -dict { PACKAGE_PIN F15 IOSTANDARD LVCMOS33 } [get_ports {b_raw[6]}] # J5-23
set_property -dict { PACKAGE_PIN F16 IOSTANDARD LVCMOS33 } [get_ports {b_raw[7]}] # J5-24
set_property -dict { PACKAGE_PIN H14 IOSTANDARD LVCMOS33 } [get_ports {b_raw[8]}] # J5-25
set_property -dict { PACKAGE_PIN G14 IOSTANDARD LVCMOS33 } [get_ports {b_raw[9]}] # J5-26
set_property -dict { PACKAGE_PIN E17 IOSTANDARD LVCMOS33 } [get_ports {b_raw[10]}] # J5-27
set_property -dict { PACKAGE_PIN D17 IOSTANDARD LVCMOS33 } [get_ports {b_raw[11]}] # J5-28
set_property -dict { PACKAGE_PIN K13 IOSTANDARD LVCMOS33 } [get_ports {b_raw[12]}] # J5-29
set_property -dict { PACKAGE_PIN J13 IOSTANDARD LVCMOS33 } [get_ports {b_raw[13]}] # J5-30
set_property -dict { PACKAGE_PIN H17 IOSTANDARD LVCMOS33 } [get_ports {b_raw[14]}] # J5-31
set_property -dict { PACKAGE_PIN G17 IOSTANDARD LVCMOS33 } [get_ports {b_raw[15]}] # J5-32

# A端只驱动LVC07逻辑输入，低驱动能力+慢沿可降低数字噪声
set_property DRIVE 4 [get_ports {a_ctrl_n[*]}]
set_property SLEW SLOW [get_ports {a_ctrl_n[*]}]

# EGO1板载USB-UART：T4为FPGA发送端，N5为FPGA接收端
set_property -dict { PACKAGE_PIN T4 IOSTANDARD LVCMOS33 } [get_ports {uart_tx}]
set_property -dict { PACKAGE_PIN N5 IOSTANDARD LVCMOS33 } [get_ports {uart_rx}]

复位策略：EGO1 的 S6/FPGA_RESET(P15)由4.7 kΩ上拉到3.3 V、按键按下接地，因此板级输入定义为低有效 rst_n。不能把外部 rst_n 直接作为所有模块的异步复位释放信号；先用2级 reset synchronizer 实现“外部按下可立即进入复位、内部复位只在sys_clk边沿同步解除”，核心模块统一使用内部 rst。FPGA尚未配置时，A端安全仍由LVC07输入10 kΩ外部上拉保证。

异步输入约束：b_raw来自线束前端，与100 MHz SYS_CLK异步。input_sync必须使用两级同步触发器，并在RTL中对同步寄存器标注 ASYNC_REG=TRUE、SHREG_EXTRACT=NO；Vivado时序约束只把 b_raw→第一级同步器D端视为异步路径，不得把第一级→第二级同步器的路径一并 false-path。等RTL实例名固定后，再写“仅命中第一级D端”的path exception，并用 get_cells/get_pins 复核目标数量确实为16；宁可暂时保留未约束告警，也不能用过宽的false-path把第二级同步路径一起掩盖。16路b_raw是16个彼此独立的异步事件通道，不把整个向量当作一个需要同拍一致性的外部数据总线。最终实现后要用 report_cdc / report_timing_summary 检查，而不是仅以“无DRC”为通过标准。

// 1) reset synchronizer：rst_n异步拉低，内部rst同步释放
(* ASYNC_REG = "TRUE", SHREG_EXTRACT = "NO" *) reg [1:0] rst_pipe;
always @(posedge sys_clk or negedge rst_n) begin
if (!rst_n) rst_pipe <= 2'b00;
else rst_pipe <= {rst_pipe[0], 1'b1};
end
wire rst = ~rst_pipe[1];

// 2) 16路异步输入同步：核心只使用b_sync
(* ASYNC_REG = "TRUE", SHREG_EXTRACT = "NO" *) reg [15:0] b_meta, b_sync;
always @(posedge sys_clk) begin
if (rst) begin
b_meta <= 16'h0000;
b_sync <= 16'h0000;
end else begin
b_meta <= b_raw;
b_sync <= b_meta;
end
end

EGO1固定接口方案
J5是2×18（36针）物理连接器：1～32脚为32路双向I/O，33/34为GND，35/36为3.3V。第一版使用1～16脚→A1～A16，17～32脚→B1～B16；33～36只用于地/电源。J5到前端板必须增加36针转接线/连接器。板载USB-UART使用独立T4/N5，不占J5，因此无需74HC595和外置CP2102/CH340。

## 4.3 开工前设计冻结：先把架构定死，再开始写RTL

现在还没有正式开做，正是最适合把接口、时序与安全边界冻结的阶段。以下决策从V1.9起作为正式开工基线：后续RTL、PCB、Testbench和上位机都围绕这些规则实现；只有真实示波器/综合数据能证明参数需要调整时才改参数，不再随意改变接口和数据流。

冻结项 | 为什么现在就定 | V1.9固定实现
A端控制语义 | a_ctrl_n[i]=0 → LVC07拉低；a_ctrl_n[i]=1 → LVC07释放（高阻） | 复位/未进入测试模式时固定16'hFFFF，任何异常都优先“全部释放”
上电安全态 | FPGA配置完成前GPIO可能高阻，LVC07输入不能悬空 | 每个LVC07输入预留10 kΩ上拉，使板卡未配置时A端默认释放
时钟架构 | 全设计只用EGO1 100 MHz主时钟 | 10 MHz波形采样、扫描节拍全部用clock-enable产生，不新建派生逻辑时钟，减少CDC风险
B端统一语义 | 核心逻辑只接受 b_conn=1(导通)/0(开路) | 真实硬件固定 b_conn=b_sync；数字自回环采用独立wrapper/TB做极性适配，生产Top不保留易配错的极性开关
静态扫描采样 | 单点采样容易落在RC/边沿过渡区 | IDLE_CHECK→DRIVE→SETTLE→SAMPLE_WINDOW→RELEASE/GUARD；首版SETTLE=500拍(5 μs)、SAMPLE_CYCLES=101拍(1.01 μs，取奇数避免多数表决平票)、GUARD_STABLE=8拍，GUARD_TIMEOUT=500拍。释放后必须回到b_conn全0稳定态，超时单独报错。
动态事件路径 | “去毛刺”可能把真正的接触抖动也过滤掉 | DYNAMIC先经过ARM_CHECK：驱动参考A通道后等待稳定，并确认b_conn等于expected_mask；通过后才使能Event Detector。动态检测读取同步后的b_conn并使用可配置最小脉宽门限；静态多数采样与动态事件捕获分离。
并发事件入队 | 16路可能同一时钟发生事件，单写口FIFO不能直接接16个Detector | 每通道设置2深度本地Event Queue（或等价2-entry skid FIFO）并置pending；轮询仲裁后写入全局FIFO。事件发生/恢复的时间戳在原通道立即锁存；Sequence只表示记录/传输顺序，不代表物理先后。若本地队列仍溢出必须累计overrun计数并在上位机可见。
波形黑匣子 | 实时上传10 MHz×16 bit不可取 | 100 MHz单时钟下用sample_ce每10拍一次，将“已同步但未做静态多数表决”的16位b_conn写入BRAM环形缓存；等效波形采样间隔100 ns，事件检测仍保持100 MHz。触发后再分包上传。
串口策略 | UART只传事件和触发后的快照 | 事件包优先；波形按块发送；采用帧头+类型+长度+序号+Payload+CRC16，禁止用ASCII连续刷波形
时序校准 | 多通道器件/走线传播延迟不完全一致 | 实验阶段给16个B端施加同一边沿，测通道间固定偏差；需要时在报告中给出skew，避免把几十ns级差异解释成真实传播顺序
复位策略 | S6(P15)为低有效按键复位；错误复位会让A端在上电/复位阶段误驱动 | P15外部rst_n先进入2级reset synchronizer；内部rst同步解除。核心模块用内部rst；复位状态a_ctrl_n全1、队列/FIFO/Trigger清零
异步输入同步 | b_raw与系统时钟异步，直接使用会有亚稳态风险 | 两级同步器+ASYNC_REG；只豁免端口到第一级的异步路径；实现后检查CDC/时序报告
动态模式准入 | 若静态拓扑本身异常，全部A拉低后动态结果失去明确含义 | 比赛/正式版本仅在reference_valid && static_pass时允许进入DYNAMIC；否则保持全部释放并提示先修复静态异常

# 5. 第一批采购清单

器件 | 数量 | 用途 | 优先级
SN74LVC07A | 5片 | 6通道开漏缓冲器；A端安全激励 | 必买
SN74LVC14A | 5片 | 6通道施密特触发器；B端边沿整形 | 必买
SN74HC4066 / 74HC4066 | 5片 | 四路双向模拟开关；可控瞬态断路。控制端高=导通、低=断开；故障发生器板上给控制端默认上拉，避免控制器未工作时随机断线 | 必买
1k/2.2k/4.7k/10k电阻 | 各20～50 | B端上拉参数实验；4.7 kΩ作为首版默认起点；10 kΩ另预留LVC07输入上电安全上拉、4066控制默认态 | 必买
220Ω/330Ω/1k电阻 | 各20～50 | 串联限流/IO保护 | 必买
100nF电容 | 50只 | 每个数字IC去耦 | 必买
1μF/10μF电容 | 各10 | 前端电源滤波 | 必买
IDC 2×10 20Pin公母座 | 6～10套 | A/B端待测线束接口；不是J5转接件 | 必买
2×18 36Pin IDC压线座/母座 | 4只左右 | EGO1 J5 到 前端板转接；1条工作线+1条备用线 | 必买
36芯灰排线 | 1～2 m | 配合2×18 IDC压线座制作J5转接线 | 必买
2×18 36Pin配套双排针/牛角座 | 2～4只 | 前端PCB/转接板端配套接口；按实际公母性选型 | 必买
20芯排线 | 若干 | 制作标准线束和故障线束 | 必买
洞洞板/万能板 | 3块 | 1路、4路原理验证 | 必买
SOP14转DIP板 | 约10块 | 若使用贴片器件进行原型焊接 | 按封装
排针/杜邦线/测试夹 | 足量 | 实验连接 | 必买
第二块MCU板 | 现有即可 | 独立故障发生器和MCU基线 | 建议
小舵机/偏心振动电机 | 各1，可选 | 重复弯折/振动真实性实验 | 后买
J5装配注意 | — | 正式版本优先使用完整2×18 36P带定位转接；若临时用2块2×10拼接，必须做Pin1/方向标识并逐针核对，避免错位或把3.3V/GND误接到I/O。 | 重要
0Ω电阻/跳线帽 | 若干 | 用于电源/调试选项；正式PCB保留可断开测试点，不允许同时短接两路电源 | 建议

预算：EGO1已经提供32路扩展I/O和板载USB-UART，因此不购买595扩展和CP2102/CH340；但必须补齐J5到前端板的36针物理转接。第一批原型材料预计约140～250元；完成16路PCB、外壳与备用件后，外围总成本预计约270～430元（不含现有EGO1开发板与实验室仪器）。

## 6. 暂时不要购买的器材

- 高速ADC：第一版检测的是数字通断事件，不需要。
- 触摸屏/独立大屏：PC显示即可。
- 毫欧计与精密模拟前端：接触电阻劣化放到第二阶段。
- 汽车24V/高压接口：第一版只验证无源低压线束。
- 复杂机械振动台：前期可控电子故障 + 手动弯折足够，后期再增加小型重复动作机构。

# 7. 实现步骤一：1路线束物理链路验证

不要直接做16路。先搭一条完整物理链，目的是确认电平、边沿、上拉参数与 FPGA 输入方向都正确。

FPGA OUT → SN74LVC07A → A ===== 待测线 ===== B → SN74LVC14A → FPGA IN
│
Rp
│
3.3V

工作逻辑：LVC07 采用开漏输出。测试时把A端拉低；正常导通时B端（LVC14输入端）被一起拉低，LVC14作为反相施密特触发器，其输出因此为高电平，FPGA原始输入 b_raw 读到1；线束开路时B端由 Rp 上拉到3.3 V，LVC14输出变为低电平，FPGA原始输入 b_raw 读到0。也就是说，真实 LVC07 + LVC14 前端下“导通=1、开路=0”。

## 7.1 B端极性归一化：RTL只允许在一个位置处理

为避免真实前端、自回环验证和不同模块各自处理极性，核心RTL从一开始就只认一种语义：b_conn[i]=1表示第i路线束导通，b_conn[i]=0表示开路/失连。真实LVC07+LVC14硬件中，LVC14输出本身已经满足“导通=1、开路=0”，因此生产Top中固定 b_conn=b_sync；topology_scanner、dynamic_event_detector和trigger_buffer均不得读取b_raw。

场景 | LVC14输入(B线) | LVC14输出 / b_raw | b_conn统一语义 | 边界层处理
真实前端：导通 | 0 | 1 | 1 = CONNECTED | 无需反相
真实前端：开路 | 1 | 0 | 0 = OPEN | 无需反相
无LVC14数字自回环TB：导通 | 0 | 0 | 1 = CONNECTED | loopback wrapper反相
无LVC14数字自回环TB：开路 | 1 | 1 | 0 = OPEN | loopback wrapper反相

自回环开发不要把调试极性参数带进最终硬件Top。建议保留两个wrapper：xunji_top_hw用于真实前端，固定b_conn=b_sync；xunji_top_loopback仅用于无LVC14自回环，内部做b_conn=~b_sync。核心模块接口完全一致。

// xunji_top_hw：真实前端
wire [15:0] b_sync;
wire [15:0] b_conn;
assign b_conn = b_sync;

// xunji_top_loopback：仅开发自回环wrapper
// assign b_conn = ~b_sync;

// 核心模块只能使用 b_conn

Testbench分两类：① tb_frontend：做“开漏状态+上拉逻辑+LVC14反相”的功能级数字模型，直接验证生产Top的极性和状态机；它不冒充真实Rp×C、施密特阈值与器件传播延迟模型，模拟前端极限仍由示波器（必要时再加SPICE）验证；② tb_loopback：使用独立loopback wrapper验证纯数字自回环。这样极性差异被隔离在边界层，不会渗入核心算法。

原型阶段同时测试 Rp = 1 kΩ、2.2 kΩ、4.7 kΩ、10 kΩ。上拉越小，上升越快，但正常导通时每路都会形成 3.3V/Rp 的静态电流。首版PCB建议默认焊4.7 kΩ、其余阻值用可替换位验证；最终阻值必须根据示波器实测的上升时间、噪声和功耗确定。

Rp | B端单路上拉电流(约) | 16路B端上拉总电流(约) | 用途建议
1 kΩ | 3.30 mA | 52.8 mA | 仅用于边沿速度/极限实验
2.2 kΩ | 1.50 mA | 24.0 mA | 候选
4.7 kΩ | 0.70 mA | 11.2 mA | 首版默认起点
10 kΩ | 0.33 mA | 5.3 mA | 低功耗候选，需重点观察RC

供电边界：上表只计算B端上拉电流，不含LVC器件本身、LED/其它板载负载，也不含动态模式下16个a_ctrl_n=0时每个10 kΩ安全上拉产生的额外约5.3 mA。EGO1手册确认J5提供3.3 V/GND，但“通用扩展I/O”章节没有给出可供外部负载的最大电流。16路正式板上电前必须实测整板电流，并结合板卡原理图/稳压器规格核对余量；未完成电源预算前，不把J5的3.3 V当作无限电流电源。第一版优先从J5同源供电，避免外部电源反向供电风险。

第一关验收

示波器同时观察 A、B、LVC14 输出。正常连接、拔线、快速触碰/断开时状态必须与预期一致；FPGA能够稳定读到变化。没有通过这一关，禁止扩16路。

# 8. 实现步骤二：4路拓扑自动重建

把1路复制成4路，先验证“盲插/认针”核心算法。4根线可以故意交叉，例如 A1→B3、A2→B1、A3→B4、A4→B2。

静态扫描时 FPGA 每次只拉低一个A通道，其余A通道释放。每轮扫描先执行IDLE_CHECK：全部A释放并等待稳定后，正常情况下所有b_conn应为0；若仍有通道为1，优先标记STUCK_LOW/对地短接/前端异常，禁止把它当成正常连接边。之后每个A通道按DRIVE→SETTLE→SAMPLE_WINDOW→RELEASE/GUARD四阶段扫描。首版把时序参数直接量化为100 MHz时钟拍数：SETTLE_CYCLES=500（5 μs），SAMPLE_CYCLES=101（1.01 μs，故意取奇数以避免多数表决50/50平票），SAMPLE_WINDOW内逐位计数并以“1的票数>50”为row_bits=1。释放后不采用固定短延时，而是要求b_conn恢复全0并连续稳定GUARD_STABLE_CYCLES=8拍；另设GUARD_TIMEOUT=500拍（5 μs）兜底并报告RELEASE_TIMEOUT。按最坏约11.01 μs/槽估算，16路一轮约176 μs（另加IDLE_CHECK），已足够快；这些参数最终由示波器实测调整。

实际线束：
A1 ───── B3
A2 ───── B1
A3 ───── B4
A4 ───── B2

系统输出：
A1 → B3
A2 → B1
A3 → B4
A4 → B2

第一次插入已确认合格的标准线束后按 LEARN，保存参考矩阵 M_ref。LEARN不是“随便插一根线就学”：参考线束必须先通过IDLE_CHECK，并满足第一版一对一范围要求（16个有效A行、16个B列的连接度均为1），否则拒绝置reference_valid。矩阵索引从现在起固定为 M[i][j]：i=0…15对应A1…A16，j=0…15对应B1…B16；row_bits[0]固定代表B1，row_bits[15]固定代表B16，序列化时按A1行到A16行的row-major顺序保存，共256 bit=32 byte。M_ref运行期间可放在FPGA寄存器；掉电后默认不保留。上位机保存Golden Map时至少写入协议版本、通道数、32 byte矩阵、生成时间和CRC/校验值，并在下次上电时重新下发和复核，避免配置文件错版或位序颠倒。之后测试同型号线束得到 M_test 再比较。

矩阵比较不要只停留在 E=M_test XOR M_ref。固定计算 Missing = M_ref & ~M_test（应有但缺失的连接）和 Extra = ~M_ref & M_test（不应有却出现的连接），同时计算每个A行和B列的连接度 degA/degB。第一版一对一线束的分类规则冻结为：M_test=M_ref时PASS；某参考连接缺失且对应行没有任何实测连接、同时不存在Extra时判OPEN/MISSING；若所有有效行和列仍满足degA=degB=1，但M_test与M_ref的映射不同，则判MISWIRE/PERMUTATION（不限于“两根互换”）；只要出现degA>1或degB>1，则优先判BRIDGE/TOPOLOGY_ANOMALY；Missing、Extra和多连接混合出现时输出组合故障掩码，无法唯一解释物理故障位置时统一给出TOPOLOGY_ANOMALY，不夸大成“已经定位到线束中某个物理短路点”。

第二关验收

4路任意交叉连接能够自动输出正确拓扑；人为制造开路、错接和桥接后，故障分类完全正确。通过后再画16路正式前端。

# 9. 实现步骤三：16路前端PCB

4路验证完成后立即扩展为16路。16路板只承担安全激励、输入整形、接口和测试点，不在前端堆复杂逻辑。

区域 | 实现 | 设计要点
A端 | 3×SN74LVC07A覆盖16路 | 开漏拉低/高阻释放；避免推挽输出短接
B端 | 3×SN74LVC14A覆盖16路 | 施密特整形，改善慢边沿和噪声
上拉 | 每路可替换电阻位 | 方便1k～10k参数优化
保护 | A端每路预留220/330Ω串联电阻位（首板4.7k上拉时建议330Ω起步） | 限制误接电流并保留边沿调优空间；最终阻值随Rp一起用示波器确认
去耦 | 每颗IC旁100nF | 保持数字前端稳定
接口 | J5侧36Pin转接 + A/B各20Pin IDC | J5负责32路FPGA信号及3.3V/GND；A/B口只负责待测16路线束及备用/NC，不把电源/地混入DUT针脚
调试 | 每路关键节点测试点 | 示波器/逻辑分析仪方便定位

第一版PCB建议两层板、尺寸稍大、标注清楚，不追求最小体积。底层尽量保持连续GND平面，J5电源入口放10 μF级总旁路，每颗LVC器件电源脚旁放100 nF去耦；LVC07尽量靠近A端接口、B端上拉与LVC14尽量靠近B端接口。A节点、B模拟节点、LVC14输出b_raw和3.3V/GND都预留测试点。比赛项目最怕“为了漂亮无法调试”。

CMOS未用通道不得悬空：3片LVC07与3片LVC14各有18个逻辑通道，实际只用16个，因此剩余2路输入必须固定到确定电平；LVC07未用输入固定高电平以保持开漏输出释放，LVC14未用输入固定到GND或3.3 V。4066未使用的控制端也必须固定，不能悬空。

## 9.1 A/B待测线束接口固定针序

A/B端采用2×10 20Pin连接器，但只有1～16脚属于16路被测信号。17～20全部定义为NC/KEY备用，第一版不把3.3 V或GND暴露到DUT接口，避免被测线束意外形成额外回路；需要示波器地参考时使用前端板独立GND测试点。A端与B端使用完全相同的物理针序，20芯排线红边统一标记Pin1。 36Pin J5转接线同样只认实际Pin1标记/板卡丝印，不按“连接器朝向习惯”猜针号；装配后用万用表逐线核对到前端PCB丝印。

物理针 | A端定义 | B端定义 | 备注
1 | A01 | B01 | 进入16×16拓扑矩阵
2 | A02 | B02 | 进入16×16拓扑矩阵
3 | A03 | B03 | 进入16×16拓扑矩阵
4 | A04 | B04 | 进入16×16拓扑矩阵
5 | A05 | B05 | 进入16×16拓扑矩阵
6 | A06 | B06 | 进入16×16拓扑矩阵
7 | A07 | B07 | 进入16×16拓扑矩阵
8 | A08 | B08 | 进入16×16拓扑矩阵
9 | A09 | B09 | 进入16×16拓扑矩阵
10 | A10 | B10 | 进入16×16拓扑矩阵
11 | A11 | B11 | 进入16×16拓扑矩阵
12 | A12 | B12 | 进入16×16拓扑矩阵
13 | A13 | B13 | 进入16×16拓扑矩阵
14 | A14 | B14 | 进入16×16拓扑矩阵
15 | A15 | B15 | 进入16×16拓扑矩阵
16 | A16 | B16 | 进入16×16拓扑矩阵
17 | NC/KEY | NC/KEY | 保留；不接3.3V/GND；不计入拓扑
18 | NC/KEY | NC/KEY | 保留；不接3.3V/GND；不计入拓扑
19 | NC/KEY | NC/KEY | 保留；不接3.3V/GND；不计入拓扑
20 | NC/KEY | NC/KEY | 保留；不接3.3V/GND；不计入拓扑

# 10. 实现步骤四：动态并行瞬态捕获

静态拓扑测试完成后切换到 DYNAMIC MODE。第一版动态模式专门解决间歇开路和接触抖动，不同时追求所有动态短路类型。

动态Event Detector与静态扫描共用统一语义 b_conn，但绝不复用静态多数表决。进入动态模式不是“直接拉低后马上开检”：先进入DYNAMIC_ARM，按参考拓扑拉低需要监测的A通道，等待DYN_SETTLE_CYCLES（首版500拍=5 μs），再要求 b_conn==expected_mask 连续稳定8拍；不满足则给出 dynamic_arm_fail_mask、立即回到全部A释放的安全态，防止一开始就处于开路却因为没有1→0边沿而被漏掉。ARM_CHECK通过后才初始化Event Detector并进入MONITOR。动态检测直接读取同步后的 b_conn 做边沿/脉宽检测，并设置可配置 MIN_PULSE_CYCLES。首次1→0采样当拍锁存 candidate_start；只有低电平持续达到门限后才置 fault_active 并产生 fault_confirm，但 T_start 仍使用最初的 candidate_start，不能用“达到门限的时刻”替代，否则会系统性低估故障宽度。Trigger Manager必须响应 fault_confirm，而不是等故障恢复后才触发。

动态模式仅在 reference_valid && static_pass 条件满足时允许请求进入，且必须再通过DYNAMIC_ARM检查；否则 safe_mode_ctrl 保持所有A端释放。MONITOR状态下，正常线束对应 b_conn 维持1，间歇开路表现为1→0，恢复为0→1。16路Event Detector真正并行工作。每个通道配置2深度本地Event Queue，已完成事件先进入本地队列，再由轮询仲裁器写入全局Event FIFO；即使多个通道同一时钟完成事件，也不会争抢单写口FIFO。若本地队列或全局FIFO溢出，必须累计overrun/overflow计数，实验报告要求为0。对于已经fault_confirm但长期不恢复的持续开路，不允许“因为没有0→1所以系统什么都不报”：FPGA持续置位 active_fault_mask；STOP/模式退出时把尚未恢复的事件按TRUNCATED/ONGOING标志封装一次，持续时间超出记录字段范围时饱和并置LONG标志。

正常： CH07 ─────────────────────────────

故障： CH07 ───────────┐ ┌────────────
└─────┘
8 μs

单条原始事件记录从现在起固定为128 bit，避免“字段想得很多但位宽装不下”：T_start=64 bit，Duration_cycles=32 bit，Sequence=16 bit，Flags=8 bit，Channel=4 bit，Reserved=4 bit，总计128 bit。T_end由 T_start+Duration_cycles 重建；100 MHz下32 bit持续时间可覆盖约42.95 s，超过时Duration饱和并置LONG/TRUNCATED标志，同时active_fault_mask继续反映正在持续的故障。Sequence只作为记录/传输编号，尤其在多通道同拍事件时，仲裁先后绝不能被解释成物理先后。每通道累计Count属于统计量，不重复塞进每条事件记录。最低可靠故障脉宽不提前承诺，由可控故障发生器与示波器实测确定。

“接触抖动”定义也要严格：第一版底层只捕获一串真实OPEN/RECOVER脉冲，不把单个短脉冲直接命名为Bounce。只有当同一通道在设定观察窗内出现多次有效开断事件时，才在统计层标记为“重复开断/抖动事件组”；如果尚未实现硬件聚合，PC可以做显示分组，但原始FPGA事件必须完整保留。

# 11. FPGA内部RTL模块划分

RTL模块 | 职责
clock_manager / ce_gen | 全系统只使用100 MHz SYS_CLK；产生scan_ce、sample_ce等clock-enable，不生成新的逻辑时钟域
safe_mode_ctrl | 上电/复位默认a_ctrl_n=16'hFFFF全部释放；模式切换先经过IDLE安全态；仅在静态DRIVE或通过DYNAMIC_ARM后允许拉低A端
drive_controller | 按静态扫描/动态模式控制16路a_ctrl_n
input_sync | 16路b_raw两级同步；b_meta/b_sync标注ASYNC_REG与SHREG_EXTRACT=NO。16位按独立异步通道处理；复位同步释放，避免亚稳态传播到核心逻辑
input_normalizer | 硬件Top固定b_conn=b_sync；核心逻辑只认1=导通、0=开路
static_sampler | IDLE_CHECK + SETTLE + SAMPLE_WINDOW多数表决；输出稳定row_bits，并单独输出stuck_low_mask
topology_scanner | 逐路扫描并构建16×16连接矩阵
golden_compare | 参考拓扑比较，标记OPEN/MISWIRE/BRIDGE；不夸大物理短路位置
timestamp_counter | 单个全局64位时间戳
event_detector ×16 | 1→0当拍锁存candidate_start；达到MIN_PULSE_CYCLES后置fault_active并输出fault_confirm；恢复时生成Duration并结束事件；持续不恢复时由active_fault_mask与STOP截断记录兜底
event_queue ×16（2深度） | 每路至少2-entry本地队列，保存已完成/截断的128-bit事件记录；带per-channel overrun计数
event_arbiter | 轮询各路非空队列，将事件串行写入全局FIFO；带global FIFO overflow计数
trigger_buffer | BRAM环形缓存；100 MHz下用sample_ce降采样写入；保存“已同步但未做静态多数表决”的b_conn状态，不建立第二时钟域
event_fifo | 缓存已仲裁事件，UART发送速度不影响捕获时刻
uart_protocol | 板载USB-UART；uart_rx先同步再过采样；二进制帧+长度+序号+CRC16，事件优先、波形触发后分块发送；baud tick用clock-enable/分数累加器，不生成新时钟域
reset_sync / safe_reset | S6(P15)低有效；异步进入安全态、同步解除复位；保证A端优先释放
trigger_manager | 状态机 ARMED→POST_CAPTURE→FROZEN/DUMP→ARMED；首个fault_confirm触发快照（不等待恢复），后续事件仍照常记录但不反复重触发
event_stats | 每通道事件计数、最短/最长脉宽、overrun；“bounce”仅在满足重复开断规则后作为统计标签
dynamic_arm_ctrl | DYNAMIC入口：驱动expected A mask→等待DYN_SETTLE→b_conn==expected_mask连续稳定8拍→ARM；失败输出dynamic_arm_fail_mask并回安全态

设计原则：只使用一个全局Timestamp，同时把“捕获”和“传输”彻底解耦。事件发生时先在通道本地锁存时间戳和持续时间，之后再排队写FIFO；UART再慢也只能拖慢上传，不能改变或丢失已经捕获的事件。

# 12. 统一时间戳与“故障时序关联”

所有通道共享EGO1的100 MHz系统时钟，全局64位Timestamp每10 ns递增一次。故障持续时间由同步后边沿的起止Timestamp差值计算。由于故障边沿相对时钟是异步的，单个边沿存在约一个时钟周期量级的采样量化/同步相位不确定性；极端亚稳态情形还可能多延迟一个周期，再叠加LVC07/LVC14传播延迟、线束RC与通道走线差异。因此“10 ns”只能叫计数颗粒，不能叫10 ns整机精度；整机脉宽误差、通道skew、抖动分布和最低可检测脉宽都必须由示波器标定。

事件窗口示例：
CH07 0 μs Intermittent Open
CH11 +3.4 μs Repeated Open Pulse
CH12 +9.1 μs Intermittent Open

正式表述使用“故障时序关联”或“事件时间序列”，不要使用“因果分析”。时间先后可以帮助工程师定位故障传播过程，但不能单独证明物理因果。

通道时序标定：在正式做多通道先后关系实验前，给16个B输入尽量同时施加同一边沿并重复多次，统计每通道相对参考通道的平均偏差、标准差和跨周期跳变概率。LVC14、前端PCB、转接线、EGO1 J5保护网络会形成较稳定的固定偏差；异步边沿进入独立同步器后还会产生不可简单“校准掉”的随机量化抖动。EGO1手册明确J5每路带过流/过压保护，因此最终通道skew和最小脉宽必须按整条真实链路标定，不能只引用LVC14数据手册传播延迟。只有重复测量证明某项偏差稳定后才做固定offset修正；时间戳相同的事件一律表述为“在当前时间分辨率内同时”，不按Event Arbiter的出队顺序强行排序。

# 13. Pre-trigger故障黑匣子

Event Detector始终在100 MHz主时钟下工作；BRAM波形缓存仍使用同一个100 MHz时钟，只通过sample_ce每10拍写一次形成10 MHz等效采样。这样不引入新的时钟域。缓存保存的是“已经过两级同步和极性归一化、但未经过静态多数表决/去毛刺”的b_conn状态。要明确区分两种分辨率：事件时间戳的计数颗粒是10 ns，而黑匣子波形的显示采样间隔是100 ns；不能拿10 MHz波形图宣称10 ns波形分辨率。

过去数据 当前
██████████████████████████████████████│
↑ Trigger

保存：T_pre（故障前） + T_post（故障后）

XC7A35T具有50个36 Kb Block RAM（总计1,800 Kb）。16路状态以10 MHz等效采样保存前2 ms+后2 ms，共40,000个16 bit样本，即640,000 bit。单纯按bit数除以36 Kb得到约18块只是理论下限；考虑RAMB36E1的实际宽深配置，16 bit宽存储通常按18 bit×2048深度映射，40,000深度需要约20个RAMB36E1。若全局Event FIFO按1024×128 bit配置，1024深度下约需4个RAMB36E1，因此这两项更合理的预估是约24/50个RAMB36，另加少量其它FIFO/控制开销；最终必须以Vivado综合/实现报告为准。Event Detector始终100 MHz全速运行；更长回放窗口再考虑板载2 Mbit异步SRAM。

Trigger策略冻结为单次快照：ARMED状态下首个fault_confirm锁存trigger_ptr并开始计POST_SAMPLES，不等待故障恢复；这保证持续数毫秒甚至更久的开路也能把故障起点保留在pre-trigger窗口内。完成后进入FROZEN，保留整段环形缓存等待上位机读取。FROZEN/DUMP期间事件检测、active_fault_mask和Event FIFO仍继续工作，但不创建新的波形快照；读取完成或CLEAR后再重新ARM。这样避免连续抖动反复改写同一快照。4 ms×16 bit×10 MHz的原始快照约80 KB；若仅用115200 baud、8N1逐字节发送，理论传输时间约6.9 s，因此115200只适合bring-up。比赛版需要实测更高稳定波特率、批量帧发送，必要时缩小显示窗口；无论上传多慢，都不得影响事件捕获和快照冻结。

# 14. 实现步骤五：独立可编程故障发生器

比赛数据不能靠“手抖一下线束”。第一轮精度标定优先用实验室信号源产生0～3.3 V兼容控制脉冲驱动SN74HC4066，并用示波器直接测量“线路实际电平”，不要只相信控制脉冲宽度。很多信号源的幅度读数按50 Ω负载标定，接高阻CMOS输入时实际幅值可能与面板显示不同，因此必须在4066控制脚处实测，保证控制电压实际落在0～VCC范围内，不能把过冲/倍幅误送进3.3 V逻辑。4066在3.3 V供电下控制端高=导通、低=断开，故障发生器板建议给控制端10 kΩ默认上拉，使控制器未启动时线路保持正常导通；若控制MCU可能断电而4066仍上电，应避免通过该上拉反向灌入未上电MCU，可加串阻/缓冲或保证二者同源上电。自动批量扫脉宽时再用独立MCU控制4066。信号源/独立MCU与故障发生器必须共地；所有未使用的4066控制输入固定到确定电平，不允许悬空。

A7 ───── SN74HC4066 ───── B7
↑
独立MCU定时器

逐步产生 1 ms、500 μs、100 μs、50 μs、10 μs、5 μs、2 μs、1 μs 等间歇开路。若1 μs依旧稳定，再向500 ns试探；最终论文/报告只写示波器验证后的实际指标。

每种脉宽至少重复500～1000次。示波器最好同时观察三处：①4066控制端（命令宽度）；②B节点模拟电压（真实RC充放电）；③LVC14输出b_raw（FPGA真正看到的数字脉冲）。这样可以区分“开关已经断开，但B节点尚未跨越施密特阈值”和“FPGA漏采”两类问题。重复脉冲之间先留毫秒级间隔，避免UART/FIFO成为检测率实验的隐藏瓶颈；吞吐压力测试再单独提高频率。做MCU基线时，故障发生器必须由信号源或另一块控制器产生，不能让同一MCU既制造故障又检测故障。

# 15. 必做实验矩阵

实验 | 变量 | 核心结果 | 作用
静态拓扑准确率 | 正常/错接/开路/桥接 | 分类准确率 | 证明基础功能
故障宽度扫描 | 1ms→1μs及以下 | Detection Rate | 最核心性能曲线
并发通道 | 1/2/4/8/16路同时事件 | 漏检率、时间误差 | 证明FPGA并行性
时间测量 | 4066控制/B节点/b_raw三点示波器测量 | FPGA脉宽误差、前端转换误差、Std/最大误差 | 区分模拟前端限制与数字捕获误差
上拉参数 | 1k/2.2k/4.7k/10k | 响应速度、误报、静态电流 | 优化前端
线束长度 | 短/中/长多组 | 最小可靠脉宽、误报率 | 分析RC与应用边界
真实接触抖动 | 松动端子/可重复弯折 | 次数与脉宽分布 | 实际应用验证
长时间运行 | 1h→8h | 误报、丢事件 | 可靠性
资源扩展 | 4/8/16路 | LUT/FF/BRAM/Fmax/WNS | 性能资源优化
MCU基线 | 相同前端与故障源 | P99延迟/漏检/CPU占用 | 证明FPGA必要性
空闲基线/卡低检测 | 全部A释放 | stuck_low_mask、误报 | 验证IDLE_CHECK与对地短接/前端异常识别
事件吞吐/队列压力 | 事件频率与并发度 | queue overrun、FIFO overflow | 证明捕获层与UART传输解耦
静态无故障误报 | 正常线束长时间静置 | False events/hour | 量化系统噪声鲁棒性

指标定义在实验前先冻结，避免事后挑阈值：Detection Rate = N_detected / N_generated ×100%。建议把“可靠最小脉宽”定义为：在N≥1000次重复、per-channel overrun=0且global FIFO overflow=0条件下，检测率≥99.9%的最小脉宽。报告同时给两条尺度：①系统级横轴用示波器确认的4066实际OFF时间/故障命令宽度，反映整机从机械等效开路到判定的能力；②数字捕获横轴用LVC14输出b_raw的实际低脉宽，反映FPGA捕获核心能力。FPGA脉宽误差以b_raw数字脉宽为基准，4066→B模拟节点→b_raw之间的差异单独作为前端转换误差，不把模拟RC失真算成FPGA计时误差。最关键图是故障持续时间—Detection Rate（FPGA与MCU同图）；第二关键图是并发事件通道数增加时的漏检率/P99响应延迟。

# 16. MCU基线必须公平

MCU使用与FPGA完全相同的前端、同一批待测线束和同一独立故障源，采用该MCU合理可实现的GPIO中断/定时器捕获/优化扫描方案，不故意写差。实验前固定MCU型号、主频、编译优化等级和中断架构；FPGA与MCU必须使用相同的“有效故障”定义和最小脉宽判据，不能一边做严格去毛刺、一边按原始边沿统计。单通道时MCU可能表现很好；项目真正要比较的是1/4/8/16路和并发事件增加时的漏检率、脉宽误差、队列/CPU负载以及（若提供物理debug脉冲）P99响应延迟。

答辩中的正确比较

不要说“FPGA主频更高”。要说：FPGA把多个事件检测器映射成真正并行的硬件，各通道共享统一时基；通道数增加时不需要把更多检测任务串行塞进一个CPU执行流。

# 17. 上位机实现

上位机建议 Python + PySide6/PyQt，仅做显示与数据管理，避免把开发时间浪费在APP和云平台。

- 拓扑页：显示 A→B 连接图，标出 PASS / OPEN / MISWIRE / BRIDGE。
- 动态页：显示16路逻辑波形、触发位置、故障脉宽。
- 事件页：显示时间、通道、类型、持续时间、次数与相关事件。
- 导出：CSV保存事件，PNG/PDF报告可以后期再加。

通信协议从第一版就固定成二进制帧，避免后期上位机与RTL各自改格式。建议帧格式：固定SOF字节序55 AA（2B）+ Version（1B）+ Type（1B）+ Length（2B）+ Sequence（2B）+ Payload + CRC（2B）；除SOF外的多字节数值统一小端。CRC版本固定为CRC-16/CCITT-FALSE：poly=0x1021、init=0xFFFF、refin=false、refout=false、xorout=0x0000，避免PC与RTL各自理解不同。“Length=2B”意味着单帧Payload最大65535 B，因此80 KB波形必须分块，建议每块1～4 KB并用Sequence/Chunk Index重组。uart_rx本身也是异步输入，进入UART采样器前先做2级同步；baud tick使用100 MHz主时钟下的clock-enable/分数累加器，不生成新的UART逻辑时钟。Bring-up可先用115200 baud，随后实测板载USB-UART在更高波特率下的稳定性。检测率实验必须同时记录FIFO/queue overflow，避免把UART吞吐限制误认为FPGA漏检；连续事件优先多条打包进同一Payload，减少每条事件重复帧头的开销。

# 18. FPGA性能与资源优化

自主选题评分明确要求目标器件上取得可测性能、给出基线对比，并合理使用片上资源。因此优化必须成为项目内容，而不是最后补一张资源表。

对象 | 初始方案 | 优化方案 | 可展示结果
时间戳 | 16个64位自由计数器 | 1个全局64位计数器+事件锁存 | 显著减少FF
事件缓存 | 每通道独立大缓存 | 事件FIFO+共享BRAM环形缓存 | 减少BRAM碎片
波形存储 | 按系统时钟全量保存 | 事件检测全速，波形降采样保存 | 减少BRAM
参数化 | 固定16路代码 | N_CHANNEL参数化生成 | 便于4/8/16路资源曲线

最终报告至少给出 LUT、FF、BRAM、Fmax、WNS，并说明每次优化为什么有效、付出了什么代价。

# 19. 完成核心后的增强功能：动态编码模式

第一版动态模式把全部A端拉低，因此对间歇开路非常敏感，但两个低电平线路突然短接时不一定可见。只有当核心功能、实验和上位机全部稳定后，才增加动态编码检测。

增强思路：每条线发送不同的低占空比/伪随机开漏码 C_i(t)，B端实时检查接收到的码型是否等于预期码。出现瞬态桥接、错连时会产生编码失配。最终可以形成 Continuity Mode（高灵敏度间歇开路）与 Coded Mode（动态开路+桥接）两个模式。

# 20. 风险点与备用方案

风险 | 表现 | 处理方案
J5 36针接口接错/错位 | J5中1～32为I/O，33/34为GND，35/36为3.3V；若排线方向、针号或公母座选错，可能造成整组信号错位甚至电源误接 | 优先完整2×18 36P带定位方案；线缆两端标Pin1；前端PCB明确1～36丝印；首次上电前用万用表逐针通断确认
B端上升太慢 | 短脉冲被RC吃掉 | 减小Rp、优化布线、换更快整形器件
施密特/同步器导致窄脉冲丢失 | 极窄故障不能采到 | 先锁定可可靠范围，再做脉冲展宽/异步捕获扩展
UART带宽不足 | 波形上传卡顿 | 事件先FIFO，波形触发后分包上传；必要时换USB-FIFO
短路误接伤板 | 前端损坏 | 开漏输出、串联限流、只测无源低压线束
真实弯折故障不稳定 | 演示复现性差 | 4066可控故障作为量化实验；另做可重复弯折故障线束作应用演示
45天功能膨胀 | 核心未做深 | 动态短路、接触电阻、AI、APP全部列为第二阶段
J5约束与物理线序不一致 | XDC能过编译但接线错位，甚至因随意换PACKAGE_PIN造成实际接口不可用 | 以第4.1节表为唯一源；XDC/36芯排线/PCB丝印三方逐针核对；禁止DRC后试错换脚
LVC14极性混用 | 数字自回环TB通过，但接真实前端后导通/开路判断完全反转 | 生产Top固定b_conn=b_sync；纯数字自回环只在独立wrapper/TB中做反相适配，不在正式Top保留可切换极性参数
上电时A端误拉低 | FPGA尚未配置/复位期间LVC07输入悬空，可能随机导通 | LVC07每个输入加10 kΩ上拉；RTL复位后a_ctrl_n=全1，默认全部释放
静态滤波吞掉动态抖动 | 多数表决/去毛刺若复用于动态路径，会把真实短脉冲当噪声删除 | 静态用采样窗多数表决；动态直接对同步后的b_conn做边沿与脉宽检测，最小脉宽门限可配置
多通道同拍事件丢失 | 16个Detector同时完成事件，若直接写单口FIFO会发生写冲突 | 每路2-entry Event Queue + pending/仲裁；事件时间戳在源通道锁存；记录per-channel overrun和global FIFO overflow，实验要求均为0
派生时钟造成CDC问题 | 为10 MHz缓存另建逻辑时钟，后期出现跨时钟域错误 | 只保留100 MHz主时钟；所有慢速节拍使用clock-enable
复位极性/释放方式错误 | 按键复位时A端被错误拉低，或异步释放导致状态机异常 | S6(P15)定义低有效rst_n；异步进入安全态、同步解除；复位期间a_ctrl_n全1
异步输入未正确约束 | 亚稳态或时序报告被错误false-path掩盖 | 两级同步+ASYNC_REG；只豁免端口到第一级；实现后检查report_cdc/report_timing_summary
3.3V供电预算不足 | 16路小Rp全导通时外部负载增大，可能使板载3.3V余量不足 | 默认4.7k起步；测整板电流并核对稳压器余量；未核实前不把J5 3.3V当作无限电源
A/B 20Pin接口定义不固定 | 20芯排线的多余4脚被随意接成电源/地，导致PCB与线束定义漂移 | 固定1～16=信号，17～20=NC/KEY；3.3V/GND只留在前端板测试点，不进入DUT接口
连续事件导致单次快照被反复覆盖 | 抖动期间多次Trigger改变缓存边界，回放不可重复 | Trigger Manager采用ARMED→POST_CAPTURE→FROZEN/DUMP；快照冻结后只记录事件，不重触发
动态模式一开始就有故障却没有边沿 | A端刚拉低时某通道已经开路，Event Detector若直接ARM会因没有1→0边沿而漏掉 | 增加DYNAMIC_ARM：等待稳定并检查b_conn==expected_mask；失败即报告dynamic_arm_fail_mask并回安全态
持续开路一直不恢复 | 只在0→1恢复时入队会导致长时间故障没有完整事件记录 | fault_confirm后立即置active_fault_mask并触发快照；STOP/退出时生成TRUNCATED/ONGOING记录，超长Duration饱和并置LONG标志
仲裁顺序被误当成物理先后 | 同拍多通道事件被轮询FIFO串行化，Sequence看起来有先后 | 物理排序只看T_start及其不确定度；同时间戳视为当前分辨率内同时，Sequence仅作记录/传输编号
UART RX/高波特率实现不稳 | PC命令偶发错帧或高波特率采样误差导致模式/配置异常 | uart_rx两级同步+过采样；baud tick用clock-enable/分数累加器；CRC+Sequence检测帧错误，任何模式切换命令只在安全状态应用
故障发生器控制幅度错误 | 信号源50Ω标定/高阻负载导致控制脚实际幅值偏离面板显示甚至超压 | 示波器直接测4066控制脚实际高低电平与过冲，保证0～VCC；自动测试时统一供电/共地并避免未上电MCU被反向灌电

# 21. 阶段验收顺序

1. 完成“实现冻结”后再建EGO1 Vivado工程：器件xc7a35tcsg324-1，100 MHz SYS_CLK(P17)，rst_n=P15，按第4.1节固定J5映射约束32路I/O；A端统一a_ctrl_n并默认全1释放。先完成GPIO/复位/双级同步/时间戳/UART最小工程，并在Vivado中同时通过DRC、report_cdc与timing summary，再进入拓扑和动态捕获。

调试阶段允许使用Vivado ILA观察scan_state、b_sync/b_conn、event_valid、Timestamp、queue level与trigger_ptr；但最终资源/时序对比必须注明“含ILA/不含ILA”，正式性能数据优先采用移除ILA后的实现，避免调试核占用BRAM和时序资源干扰结论。

2. 1路链路通过：示波器与FPGA均能正确看到连接/开路变化。
3. 4路拓扑通过：任意交叉线能够自动重建映射。
4. 4路静态故障通过：先通过全A释放IDLE_CHECK，再验证OPEN/MISWIRE/BRIDGE；复杂异常无法唯一定位时正确输出TOPOLOGY_ANOMALY。
5. 4066可控故障通过：至少10 μs级断路能稳定捕获并测量持续时间。
6. 完成16路PCB与参数化RTL，拓扑与静态故障全部稳定。
7. 完成16路真正并行Dynamic Mode、DYNAMIC_ARM检查、active_fault_mask、全局Timestamp、每路2深度Event Queue、仲裁器和全局Event FIFO；验证“进入动态前已开路”“持续开路不恢复”“16路同拍完成事件”三类边界场景，仿真与上板压力测试均不得出现未解释丢事件。
8. 完成Pre-trigger黑匣子与PC波形回放。
9. 完成故障宽度、并发通道、上拉参数、线束长度、长时间运行实验。
10. 完成MCU公平基线与FPGA资源/时序优化。
11. 若以上全部完成，再做动态编码模式或自动弯折可靠性实验。

# 22. 最终现场演示流程

1. 插入标准16芯线束，点击 LEARN，系统建立参考拓扑。

2. 插入错接/断路/桥接线束，系统自动指出具体针脚与 Expected / Actual。

3. 换回一根静态检测完全 PASS、但连接器存在间歇故障的线束。

4. 系统确认reference_valid、静态检测PASS且DYNAMIC_ARM基线检查通过后才进入MONITOR；弯折/振动线束，首次有效异常达到MIN_PULSE门限时即产生fault_confirm并冻结故障前后的波形快照，不等待线路恢复。

5. 展示原始事件列表：通道、起止时间戳、持续时间、序号；重复开断时再展示每通道计数和“抖动事件组”统计，避免把单个短脉冲直接命名为Bounce。

6. 最后展示量化数据：最低可靠故障脉宽、检测率、并发能力、MCU对比以及FPGA资源优化。

# 23. 赛道呈现重点

按2026 AMD自主选题赛道要求，作品要同时体现创新与应用价值、性能与资源优化、功能正确与完整、大模型协作/Skill以及可复现性。项目材料中不要把“断路、短路、错接”本身当作创新；它们只是完整产品的基础功能。

真正需要反复强调的三件事

① 多通道并行捕获：不是逐路轮询；② 确定性统一时间戳：所有异常在同一硬件时基下记录；③ 动态微瞬态：抓住传统静态通断测试最容易漏掉的随机、短持续时间互连失效。

建议最终项目表述：本项目利用 FPGA 的并行硬件结构与统一确定性时基，面向复杂线束动态机械工况下难以复现的瞬态互连故障，实现从静态拓扑重建到动态微瞬态捕获、波形回溯和事件时序关联的一体化诊断。

# 24. Skill与工程复现（比赛加分项）

工程完成后，把项目中真正可迁移的FPGA能力整理成通用Skill，而不是只写“如何运行本项目”。建议形成 multi_channel_event_capture_skill：

- 参数化 N 通道 Event Detector；
- 全局 Timestamp + 事件锁存模板；
- 可配置 Pre-trigger BRAM Buffer；
- 事件 FIFO 与UART协议模板；
- 自动Testbench/故障脉宽扫描脚本；
- Vivado资源和时序报告自动解析脚本；
- 窄脉冲、输入同步、毛刺、BRAM循环缓存常见问题排查清单。

这样换成编码器阵列、按钮阵列、传感器阵列、多路数字故障监测仍能复用，符合赛道对Skill“可迁移、可验证”的要求。

# 25. 当前立刻执行的三件事

A｜先冻结接口和验证规则
固定J5→a_ctrl_n/b_raw映射、P15低有效复位、b_conn=1导通语义、A/B 20Pin针序（1～16信号、17～20 NC）、A端上电默认释放、100 MHz单时钟+clock-enable、IDLE_CHECK+静态扫描四阶段、2-entry Event Queue仲裁与Trigger Manager。冻结后这些接口不再随意改。

B｜下第一批料
LVC07、LVC14、HC4066、1k/2.2k/4.7k/10k电阻、220Ω/330Ω保护电阻、100nF电容、A/B端IDC 2×10与20芯排线、J5侧2×18 36P转接件、36芯排线、洞洞板。首板B端默认4.7k；10k中预留LVC07输入上电上拉和4066控制默认上拉。

C｜器件到货前先做“仿真先行”
先完成reset/输入同步TB、IDLE_CHECK+静态扫描FSM TB、LVC14真实极性功能TB、Golden Map位序/一对一合法性TB、DYNAMIC_ARM初始故障TB、短脉冲门限+持续开路TB、16路同拍事件TB、2-entry Event Queue/FIFO溢出TB、Trigger Manager与BRAM环形缓存TB、UART CRC/错帧TB；再做EGO1 4路自回环。仿真同时覆盖queue overrun、FIFO full、连续Trigger、同时间戳事件与STOP截断事件等异常分支。

# 26. V1.9最终严格审计后的实现原则

V1.9是在V1.8基础上的第二轮“按真实RTL/硬件会不会翻车”审计。本轮发现并修正了仍然存在的实现级缺口：①一对一线束的MISWIRE分类不再局限“两根互换”，改为Missing/Extra+行列连接度；②固定Golden Map矩阵位序与LEARN合法性校验；③增加DYNAMIC_ARM，避免进入动态时已经开路却无边沿可抓；④增加active_fault_mask与STOP截断记录，解决持续开路永不恢复时无法入队；⑤把128-bit事件记录字段真正配平，并明确Sequence不代表物理先后；⑥修正BRAM估算，40,000×16位环形缓存按实际RAMB36宽深配置约需20块，加1024×128事件FIFO约4块，而不是简单按bit数估成18块；⑦区分10 ns事件计数颗粒与100 ns波形回放采样；⑧UART RX纳入CDC/波特率设计并固定CRC-16/CCITT-FALSE；⑨信号源50Ω幅度、持续故障、同步器随机量化抖动都纳入实验边界；⑩修正16路PCB接口描述中“备用/地”与NC定义的冲突。V1.9可作为正式开工基线；后续允许依据真实波形、Vivado资源/时序与实验数据调整SETTLE、Rp、MIN_PULSE、UART波特率、队列深度等参数，但J5/XDC、A/B针序、b_conn语义、reset/CDC原则和数据记录语义不得无依据反复变更。

# 附：平台与赛道依据

平台参数及J5引脚映射依据 EGO1 V2.2 用户手册核对：同一块EGO1开发板搭载XC7A35T-1CSG324C，提供100 MHz时钟P17、逻辑复位P15、J5 2×18扩展接口、USB-UART/JTAG和2 Mbit异步SRAM；J5 1～32对应PACKAGE_PIN以手册第14节为唯一板级基准，J5原理图明确35/36为3.3V、33/34为GND。XC7A35T资源量以AMD 7 Series FPGA Overview/产品表核对；LVC07/LVC14/HC4066的开漏、施密特和模拟开关特性以Texas Instruments正式数据手册为准。赛道路线继续按《2026 FPGA创新设计赛道选题指南（AMD）》的真实上板、实测、基线对比、资源优化、可复现与Skill要求组织。 本文第一版DUT范围固定为16芯无源低压点到点一对一线束，特殊多分支拓扑留到扩展版本。

# 27. 开工前GO / NO-GO检查表

检查项 | GO条件
板级引脚 | J5 1～32、P17、P15、T4/N5已按官方手册复核；XDC不含试错脚位
物理连接 | J5与A/B连接器Pin1均按实物丝印确认并逐线通断核对；A/B 1～16信号、17～20 NC/KEY，DUT接口无3.3V/GND
安全默认态 | FPGA未配置时LVC07输入有10k上拉；P15外部rst_n经reset synchronizer后生成内部rst；a_ctrl_n复位全1；4066控制端不悬空
供电 | 16路前端实测电流完成；J5 3.3V供电余量已核对；未核对则禁止上正式16路板
输入同步 | b_raw两级同步+ASYNC_REG；CDC/Timing报告无未解释问题
静态算法 | 一对一DUT范围冻结；M[i][j] row-major位序固定；LEARN只接受行/列连接度均为1的已知合格参考；IDLE_CHECK、稳定空闲GUARD、Missing/Extra+degA/degB、TOPOLOGY_ANOMALY与Golden Map保存/下发均已进TB/协议
动态算法 | DYNAMIC_ARM基线检查通过后才MONITOR；candidate_start保留真实起点；MIN_PULSE只决定有效性；fault_confirm即触发快照；持续故障由active_fault_mask+STOP截断记录兜底
并发事件 | 16路同拍+连续事件TB通过；128-bit记录字段位宽闭合；Sequence不用于物理排序；per-channel overrun/global overflow均可读且正常为0
Pre-trigger | ARMED→POST_CAPTURE→FROZEN/DUMP状态机TB通过；快照期间事件捕获不停
实验链 | 示波器可观察4066控制、B模拟节点、LVC14输出b_raw；故障源独立于被比较的FPGA/MCU；J5整链路纳入标定
上板准入 | 1路示波器验证通过后才扩4路；4路完整通过后才下16路PCB
存储资源 | 40,000×16位Pre-trigger按RAMB36实际宽深配置预算约20块；1024×128 Event FIFO约4块；综合结果与预估偏差必须解释，不能只按总bit数估算
UART链路 | uart_rx两级同步；baud tick不生成新时钟；CRC-16/CCITT-FALSE参数与PC一致；80KB波形能正确分块/重组；高波特率通过长包误码测试后才能用于比赛
持续故障 | 动态模式中先开路/长期不恢复/STOP退出三种场景均有明确状态、active mask和事件记录，不允许“无恢复就无记录”

瞬迹项目｜队内技术实施稿 第 页
