250888/fpga2026-42161/skill/README.md

# Skill 包 — 本项目沉淀的可复用经验

> 按《2026 FPGA 创新设计赛道选题指南（AMD）》§3.3.5.2 提交。
> 评价标准是**可复用性**：一支陌生队伍拿到本目录，能否直接用在自己的题目上。
> 每项均按「适用场景 / 使用方法 / 失效条件 / 已验证效果 / 提炼来源」五段书写。

## 索引

| # | 文件 | 类型 | 适用场景 | 与本题是否绑定 |
|---|---|---|---|---|
| 1 | [`hw-bringup-pitfalls.md`](hw-bringup-pitfalls.md) | 踩坑清单 | 自焊 FPGA 外扩板的**通道级**排障（一路或多路不通 / 乱报） | 否，任何「FPGA + 自焊模拟前端」通用 |
| 2 | [`golden-frame-regression.md`](golden-frame-regression.md) | 校验脚本 | 自定义串口/总线帧协议，**RTL 与主机两侧同时回归** | 否，任何定长帧协议通用 |
| 3 | [`report-templating.md`](report-templating.md) | 案例模板 | 拿到比赛 docx 模板后，**用脚本填充**而不是手写 | 否 |
| 4 | [`poster-templating.md`](poster-templating.md) | 案例模板 | 拿到官方 pptx 海报模板后生成中英双语版 | 否 |
| 5 | [`win-launcher-packaging.md`](win-launcher-packaging.md) | 工具 | 中文文件名/中文路径的上位机一键打包与启动器 | 否 |

## 通用前提

- Windows 10/11 + Python 3.12 + [`uv`](https://docs.astral.sh/uv/)
- 脚本路径以**仓库根目录**为基准
- 涉及 Vivado 的条目需本机已装 Vivado（本项目用 2026.1）

## 为什么这些值得复用

本项目的 16 通道外扩板是**手工焊接**的，排障占了整个开发周期的一大半；
自定义 48 字节帧协议在 RTL 与 Python 两侧各有一份实现；
报告与海报都是**按官方模板批量生成**而非手写。
这三类问题在同类竞赛项目里几乎人人都会遇到，所以把它们整理成可迁移的清单与脚本。

## 复用验证

| 项 | 验证方式 | 结果 |
|---|---|---|
| 1 踩坑清单 | 在本项目上使故障通道从 11 路收敛到 0 路 | 16/16 全通 |
| 2 黄金帧回归 | 在 B1 缺陷（帧矩阵未快照）上复现并拦截 | 抓到并回归通过 |
| 3 报告模板 | 从模板生成 13→16 页报告，含 2 张自动表格 | 通过 |
| 4 海报模板 | 生成中英各一页，含 AMD 标识与校标 | 通过 |
| 5 打包工具 | 中文文件名上位机打包后解压哈希与源一致 | 通过 |
