250888/fpga2026-42161/doc/瞬迹_海报_中英_终版.pptx

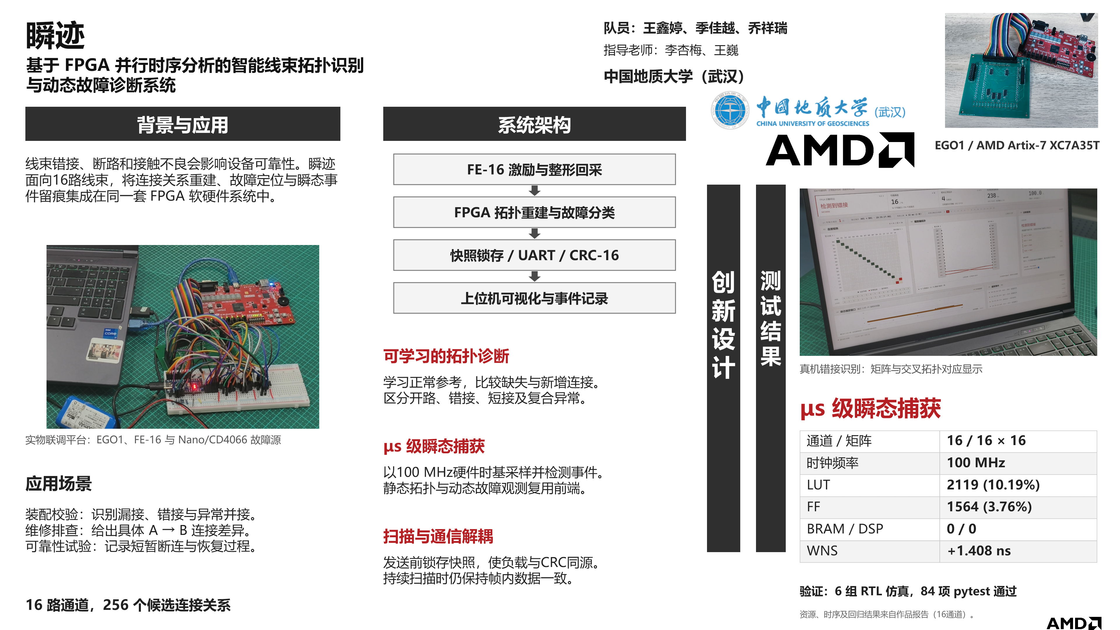
[picture p17: figure]

## Slide 2

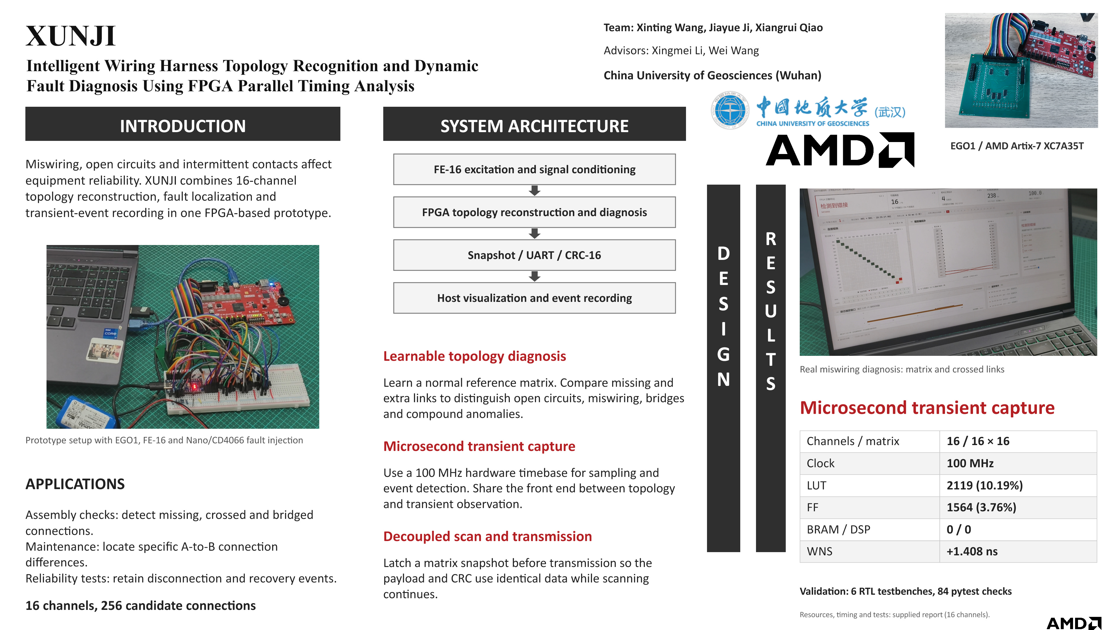
[picture p18: figure]
