250888/fpga2026-42161/doc/XUNJI_Poster_English_含校徽.pdf

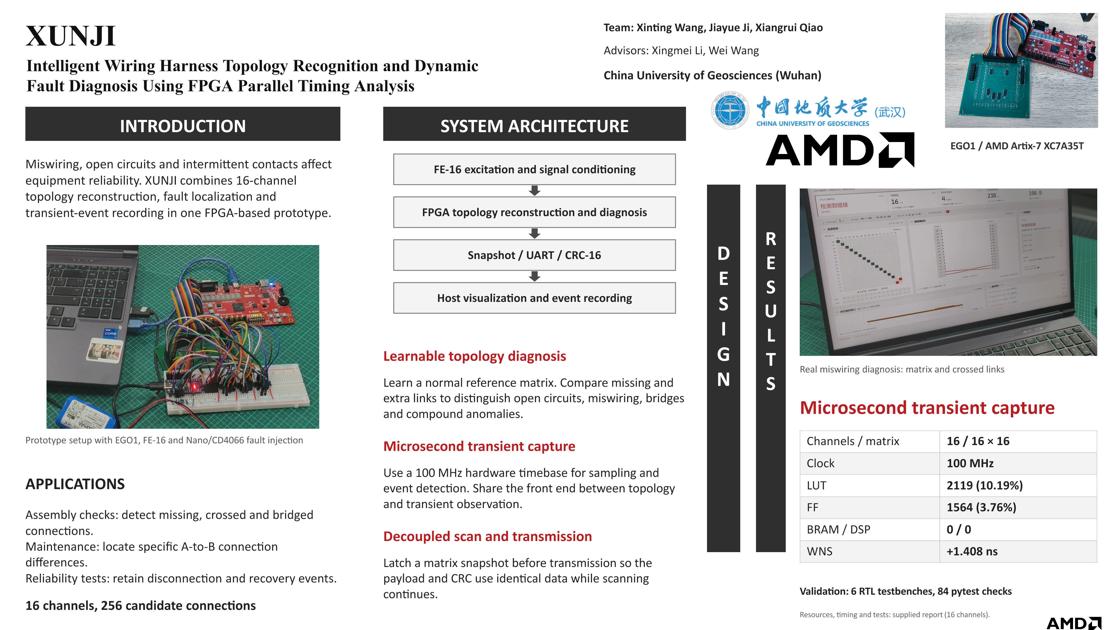
[picture p19: page 1]
