250888/fpga2026-42161/doc/瞬迹_海报_中文版_含校徽.pdf

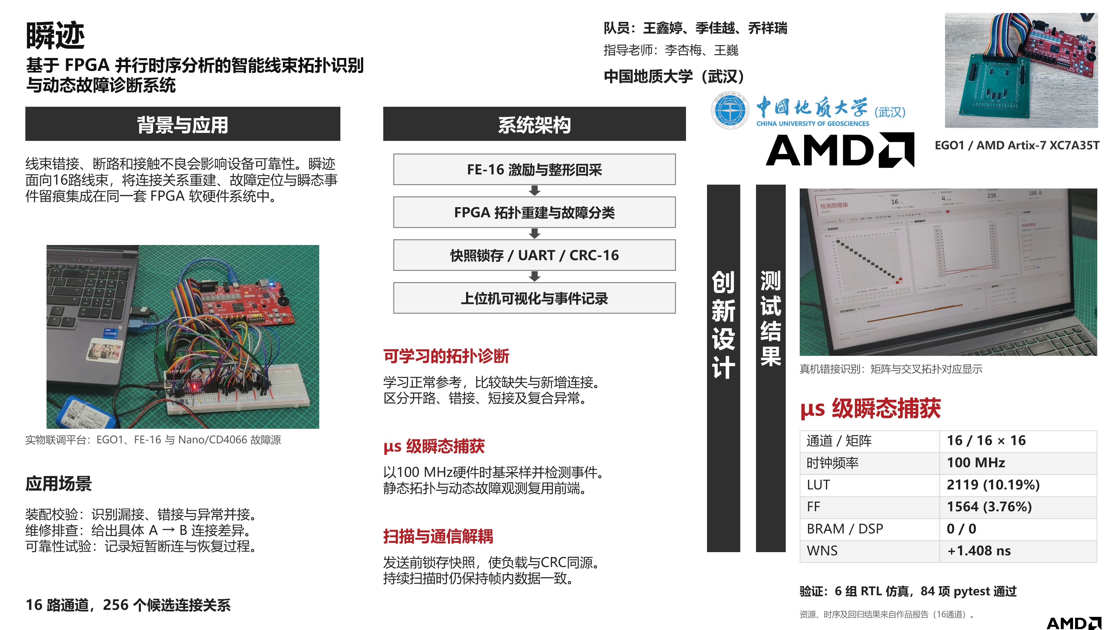
[picture p20: page 1]
