250888/fpga2026-42161/doc/case/layout_concept.png

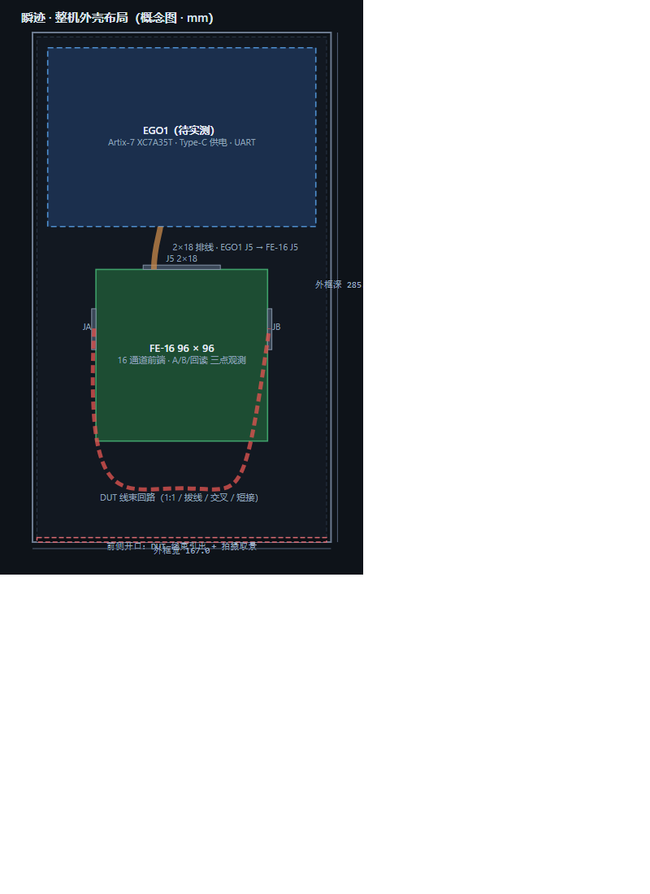
doc/case/layout_concept.png
