250888/fpga2026-42161/doc/case/out/preview_xunji_case_base.png

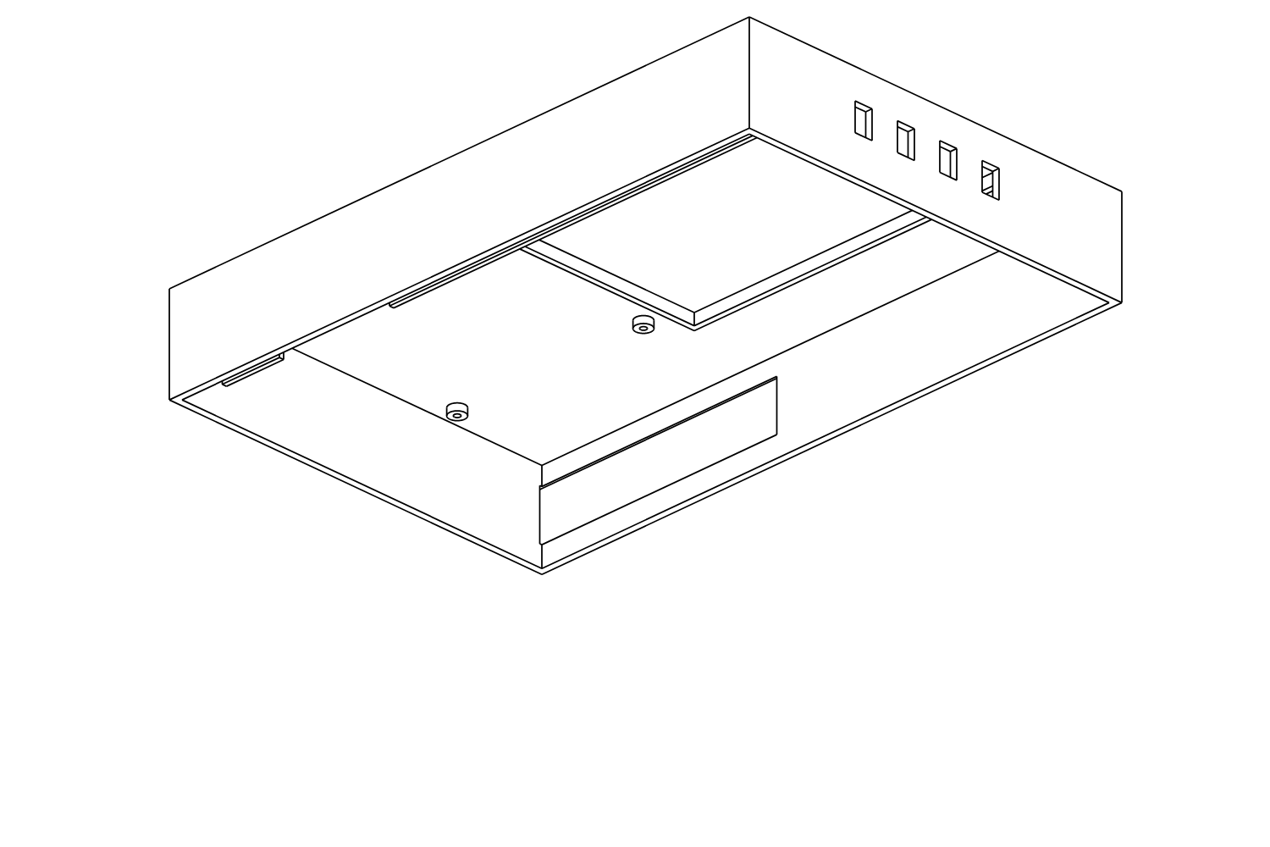
doc/case/out/preview_xunji_case_base.png
