250888/fpga2026-42161/doc/fe16_svg/pcb_top_render.png

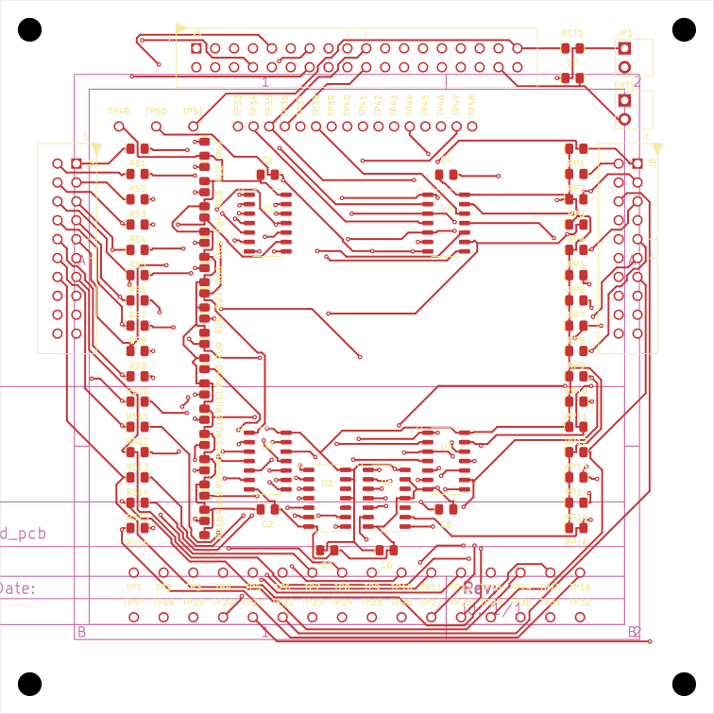
doc/fe16_svg/pcb_top_render.png
