250888/fpga2026-42161/doc/fe16_svg/xunji_fe16_render.png

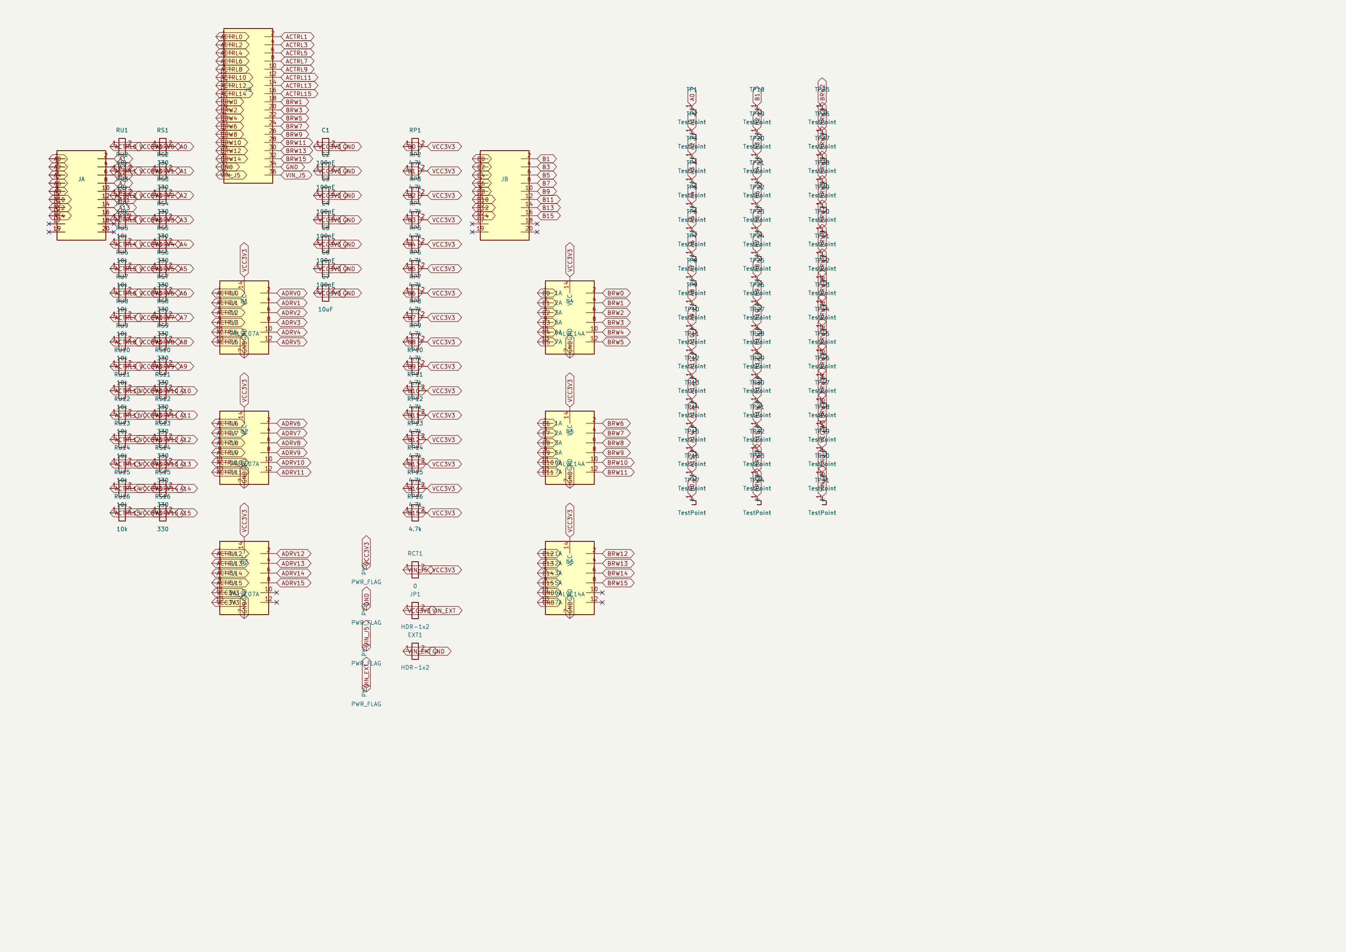
doc/fe16_svg/xunji_fe16_render.png
