250888/fpga2026-42161/doc/photous/动态，事件取证与回放.png

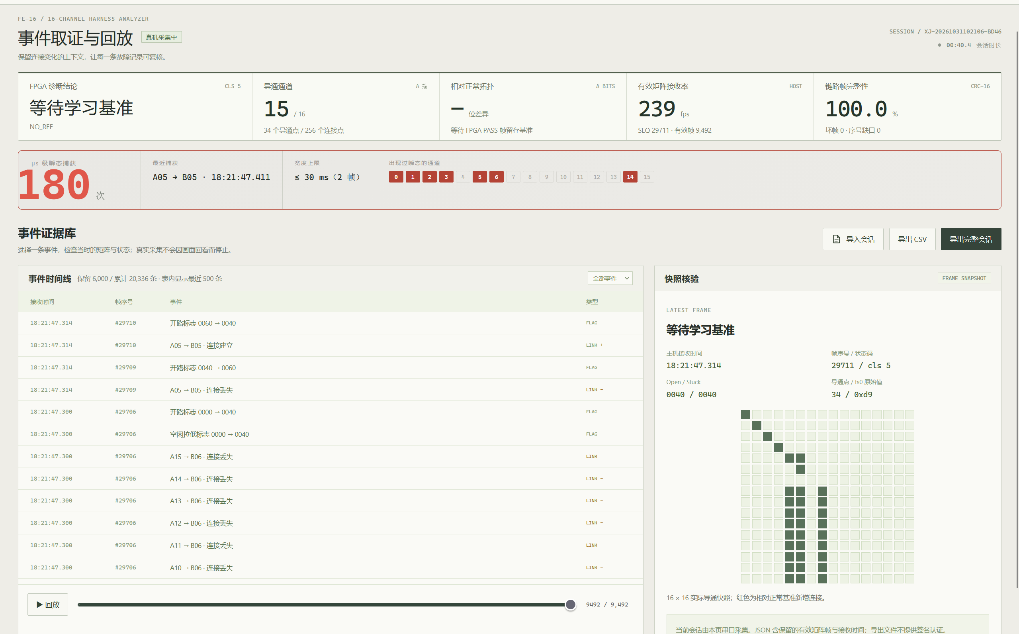
doc/photous/动态，事件取证与回放.png
