250888/fpga2026-42161/doc/photous/动态，系统技术链路.png

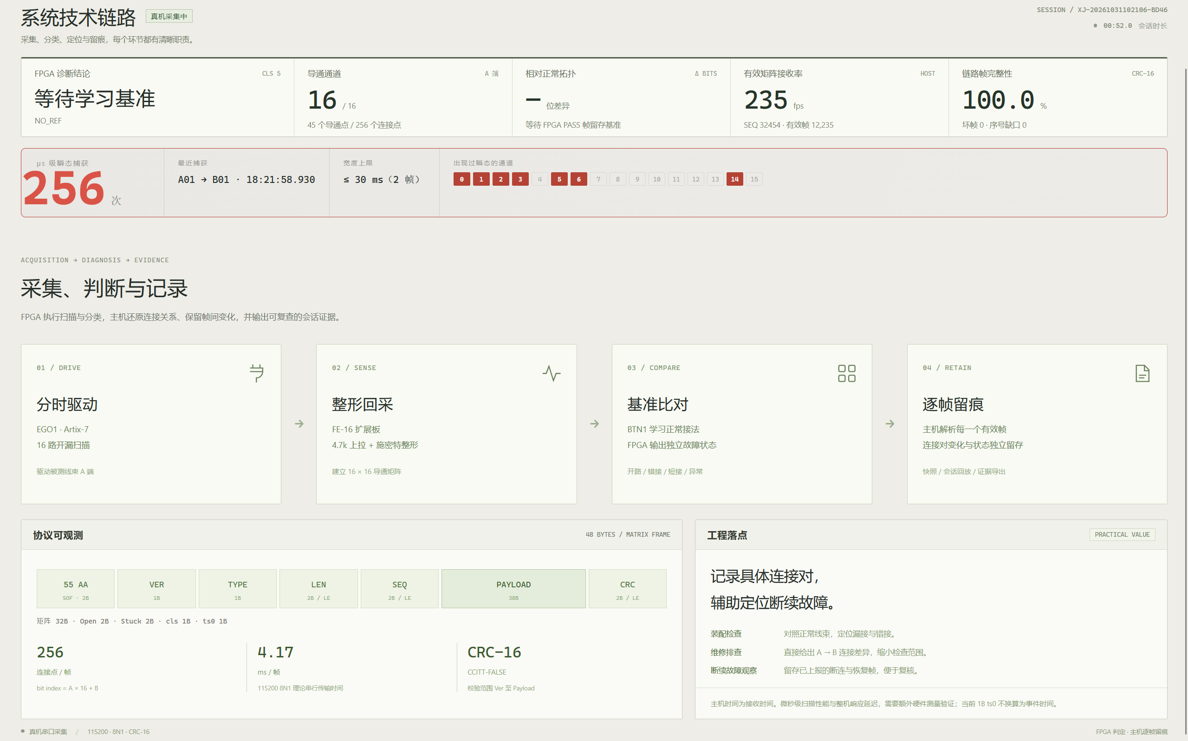
doc/photous/动态，系统技术链路.png
