250888/fpga2026-42161/doc/photous/动态，线束拓扑诊断.png

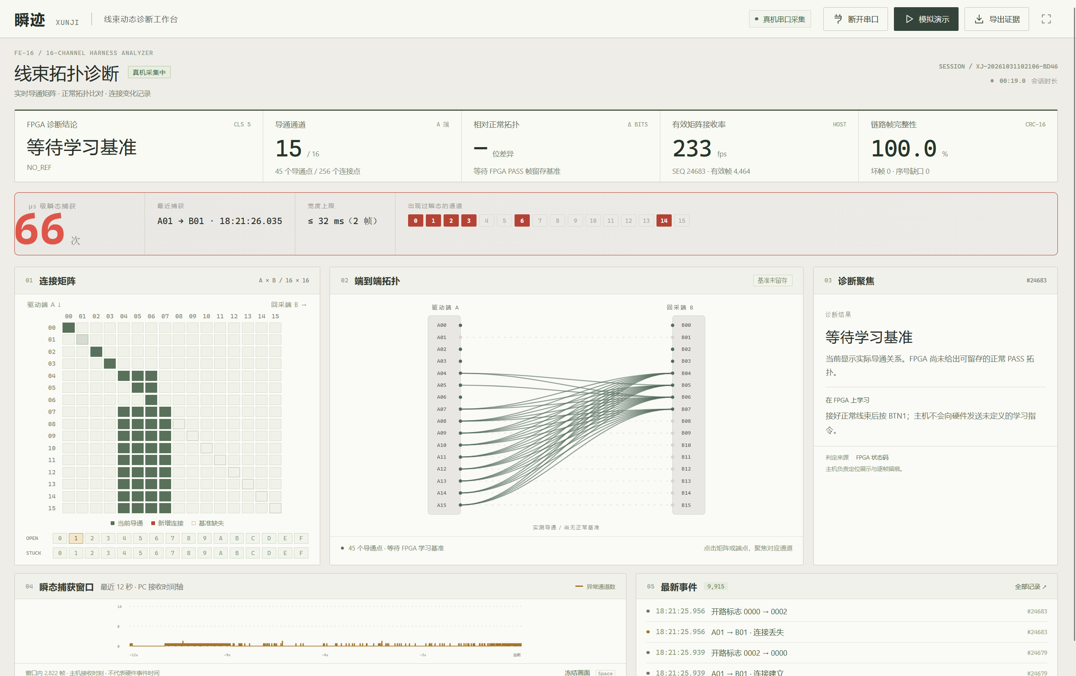
doc/photous/动态，线束拓扑诊断.png
