250888/fpga2026-42161/doc/photous/外壳​.jpg

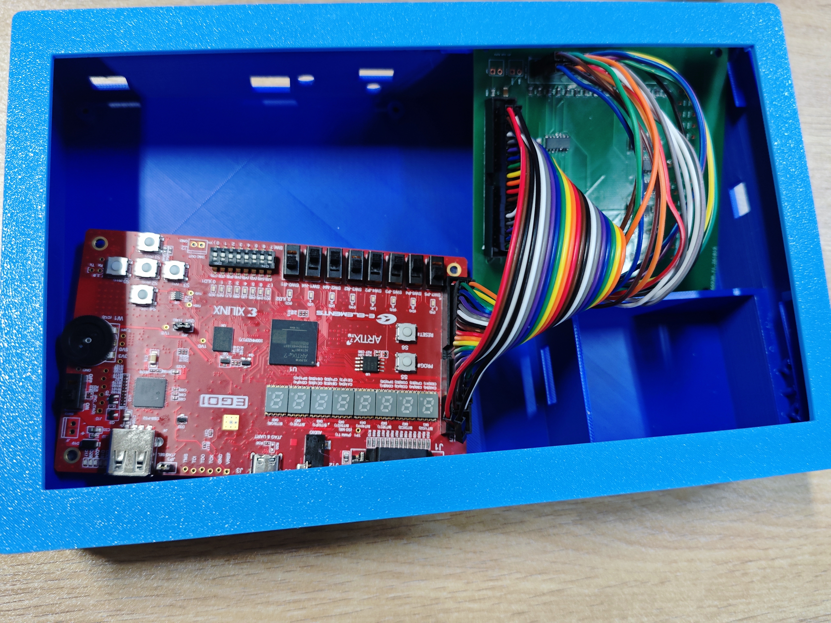
doc/photous/外壳 .jpg
