250888/fpga2026-42161/doc/photous/屏幕截图 2026-10-31 172634.png

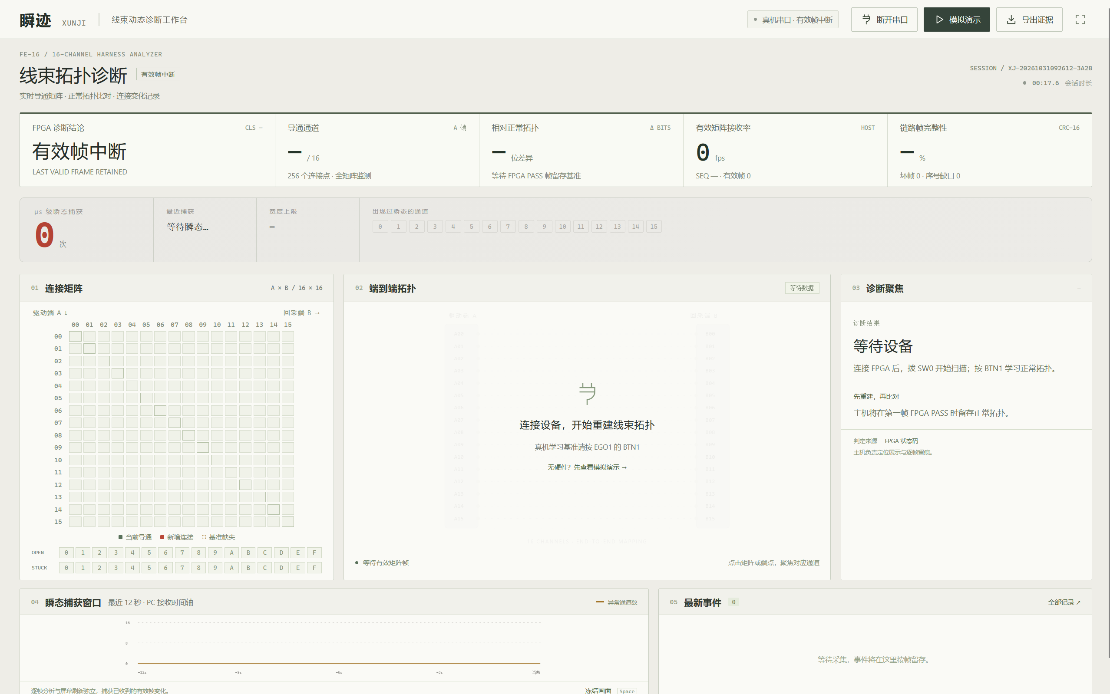
doc/photous/屏幕截图 2026-10-31 172634.png
