250888/fpga2026-42161/doc/photous/静态，实物图.jpg

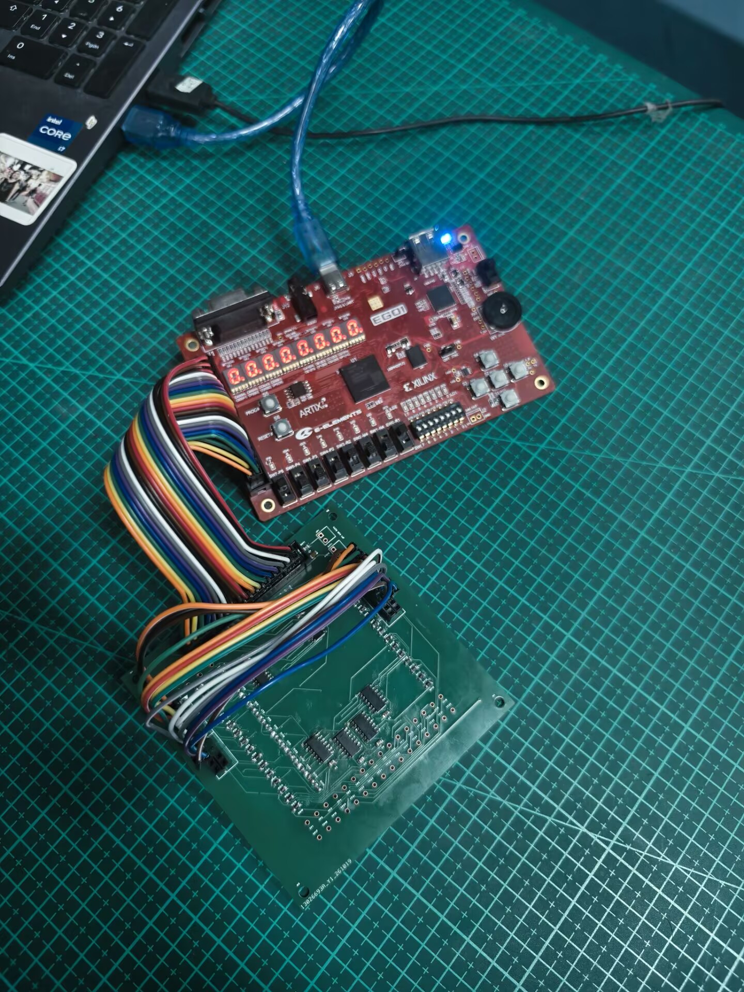
doc/photous/静态，实物图.jpg
