250888/fpga2026-42161/doc/工作台_预览.png

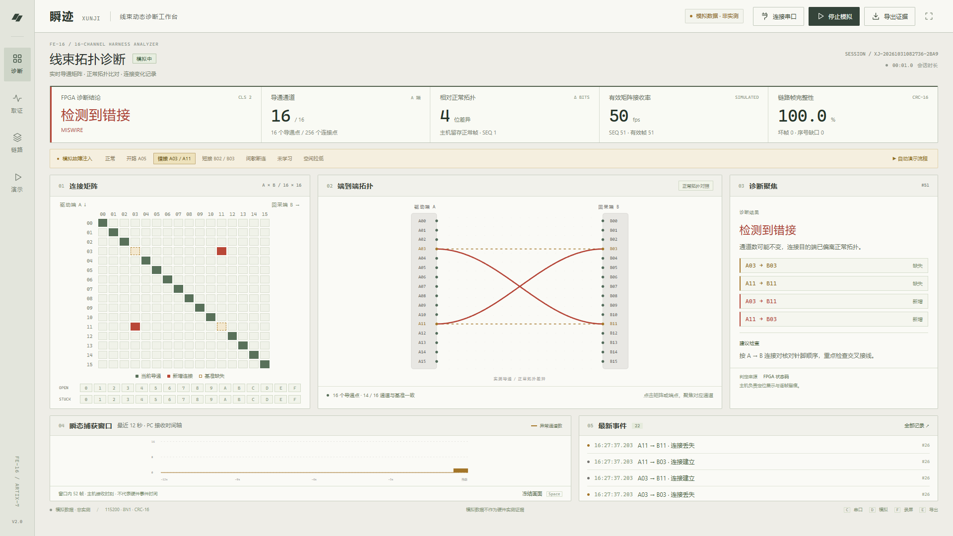
doc/工作台_预览.png
