250888/fpga2026-42161/pcb/eda_fab/BOM_review_for_team_2026-10-17.md

# xunji_fe16 板 BOM 采购审查清单（2026-10-17）

板型：xunji_fe16_1（FE16 探测器接口板）  
BOM：**11 组物料 / 67 件贴装与插件元件**（另有测试点 51 个、安装孔 4 个，不采购）  
全部物料已绑定立创商城编号。

## 一、BOM 明细

| # | 位号 | 值 | 封装 | 立创编号 | 数量 | 物料 | 贴装 |
|---|---|---|---|---|---|---|---|
| 1 | C1,C2,C3,C4,C5,C6 | 100nF | R_0805_2012Metric | C28233 | 6 | 100nF ±10% 100V X7R 0805（三星 CL21B104KCFNNNE） | 贴片(SMT) |
| 2 | C7 | 10uF | R_0805_2012Metric | C15850 | 1 | 10µF ±10% 25V X5R 0805（三星 CL21A106KAYNNNE） | 贴片(SMT) |
| 3 | EXT1,JP1 | HDR-1x2 | PinHeader_1x02_P2.54mm | C9900010030 | 2 | 2.54mm 单排排针 1x2 直插 | 插件(THT) |
| 4 | J5 | IDC-2x18 | IDC-Header_2x18_P2.54mm | C55160413 | 1 | 2.54mm IDC 简牛座 2x18 直插 | 插件(THT) |
| 5 | JA,JB | IDC-2x10 | IDC-Header_2x10_P2.54mm | C9900016201 | 2 | 2.54mm IDC 简牛座 2x10 直插 | 插件(THT) |
| 6 | RCT1 | 0 | R_0805_2012Metric | C17477 | 1 | 0Ω ±1% 125mW 0805 厚膜电阻 | 贴片(SMT) |
| 7 | RP1,RP2,RP3,RP4,RP5,RP6,RP7,RP8,RP9,RP10,RP11,RP12,RP13,RP14,RP15,RP16 | 4.7k | R_0805_2012Metric | C17673 | 16 | 4.7kΩ ±1% 125mW 0805 厚膜电阻 | 贴片(SMT) |
| 8 | RS1,RS2,RS3,RS4,RS5,RS6,RS7,RS8,RS9,RS10,RS11,RS12,RS13,RS14,RS15,RS16 | 330 | R_0805_2012Metric | C17630 | 16 | 330Ω ±1% 125mW 0805 厚膜电阻 | 贴片(SMT) |
| 9 | RU1,RU2,RU3,RU4,RU5,RU6,RU7,RU8,RU9,RU10,RU11,RU12,RU13,RU14,RU15,RU16 | 10k | R_0805_2012Metric | C17414 | 16 | 10kΩ ±1% 125mW 0805 厚膜电阻 | 贴片(SMT) |
| 10 | U1,U2,U3 | SN74LVC07A | SOIC-14_3.9x8.7mm_P1.27mm | C7659 | 3 | SN74LVC07ADR 六路开漏缓冲器 SOIC-14（TI） | 贴片(SMT) |
| 11 | U4,U5,U6 | SN74LVC14A | SOIC-14_3.9x8.7mm_P1.27mm | C133541 | 3 | SN74LVC14ADR 六路施密特反相器 SOIC-14（TI） | 贴片(SMT) |

## 二、审查结论（按原理图值逐项核对）

- **值与封装：11 组全部一致，未发现采购错误。** U1–U3 = 74LVC07A ↔ SN74LVC07A（SOIC-14）；U4–U6 = 74LVC14A ↔ SN74LVC14A（SOIC-14）；RU=10k、RS=330、RP=4.7k、RCT1=0Ω 与原理图值一致；C1–C6=100nF、C7=10µF 与原理图一致。
- **类型**：J5/JA/JB 为 IDC 排线座（简牛），JP1/EXT1 为 1x2 排针，均为 2.54mm **直插件**，不参与 SMT 贴片。

## 三、需要队友确认的点（不是错，是设计意图）

1. **电容耐压**：C1–C6 选了 100V、C7 选了 25V 的料（均为 Basic 库常规件）。若电源 ≤5V 可降额，但当前价格影响很小。
2. **U1–U3 开漏**：SN74LVC07A 是**开漏输出**（需要上拉电阻，见 RP 组）。若原意是推挽输出应为 74LVC07（无 A）——原理图标注的是 74LVC07A，按图采购没错，请确认设计本意。
3. **IDC 锁扣/防呆**：当前选的是标准简牛（无锁扣）。若线缆需要防脱落或防插反，请告知更换型号。
4. **JP1 与 RCT1 二选一**：JP1（1x2 跳线）与 RCT1（0Ω）是互斥配置，装配时只装一个。

## 四、生产文件

- Gerber：`Gerber_xunji_fe16_2026-10-17.zip`（9 层 + 3 钻孔 + 飞针 + PCB 信息，标准立创包）
- BOM：`BOM_xunji_fe16_2026_10_17.xlsx`（本清单同源）
- CPL：`PickAndPlace_xunji_fe16_2026_10_17.xlsx`（122 元件坐标，mm）
- 工程快照：`eda_project/xunji_fe16_kicad_2026-10-17_final.epro2`
