250888/fpga2026-42161/pcb/eda_fab/BOM_采购清单_淘宝版_2026-10-17.md

# xunji_fe16 板 采购清单（淘宝版，2026-10-17）

> 板型：xunji_fe16_1（FE16 探测器接口板）
> 共 11 种物料、67 件（含插件），另需测试点/安装孔不采购。
> **下表"淘宝搜索词"可直接复制到淘宝搜索框。**

## 一、物料明细

| # | 类别 | 规格型号 | 封装/间距 | 数量 | 淘宝搜索词 | 备注 |
|---|---|---|---|---|---|---|
| 1 | 陶瓷电容 | **100nF（0.1µF）±10% X7R 50V** | 0805 | **6** | `0805 100nF 50V X7R 贴片电容` | 任意品牌（三星/村田/风华均可）；50V 或 100V 都行 |
| 2 | 陶瓷电容 | **10µF ±10% X5R 25V** | 0805 | **1** | `0805 10uF 25V X5R 贴片电容` | ⚠️ 是 10µF（微法），别买成 10nF |
| 3 | 贴片电阻 | **0Ω（0R）±1% 1/8W** | 0805 | **1** | `0805 0R 1% 贴片电阻` | 跳线位（RCT1） |
| 4 | 贴片电阻 | **4.7kΩ ±1% 1/8W** | 0805 | **16** | `0805 4.7K 1% 贴片电阻` | 上拉（RP1-16） |
| 5 | 贴片电阻 | **330Ω ±1% 1/8W** | 0805 | **16** | `0805 330R 1% 贴片电阻` | LED 限流（RS1-16） |
| 6 | 贴片电阻 | **10kΩ ±1% 1/8W** | 0805 | **16** | `0805 10K 1% 贴片电阻` | 下拉（RU1-16） |
| 7 | 逻辑芯片 | **SN74LVC07ADR**（六路开漏缓冲器） | **SOIC-14** | **3** | `SN74LVC07ADR SOIC-14` | ⚠️ 后缀必须是 **ADR（SOIC-14）**，不要 PW（TSSOP）；开漏输出 |
| 8 | 逻辑芯片 | **SN74LVC14ADR**（六路施密特反相器） | **SOIC-14** | **3** | `SN74LVC14ADR SOIC-14` | ⚠️ 后缀 **ADR（SOIC-14）**，不要 PW（TSSOP） |
| 9 | 排针 | **2.54mm 单排 1x2 直针** | 2.54mm | **2** | `2.54mm 单排针 1x2 直针` | 插件，JP1/EXT1 |
| 10 | IDC 简牛座 | **2.54mm 双排 2x10（20P）直插** | 2.54mm | **2** | `2.54mm 简牛座 2x10 IDC 20P` | 插件，JA/JB；建议买带防呆缺口的 |
| 11 | IDC 简牛座 | **2.54mm 双排 2x18（36P）直插** | 2.54mm | **1** | `2.54mm 简牛座 2x18 IDC 36P` | 插件，J5；建议买带防呆缺口的 |

## 二、采购注意事项

1. **芯片封装**：U1-U3 和 U4-U6 必须是 **SOIC-14 宽体（3.9mm 宽，1.27mm 间距）**，买 **ADR** 后缀；**不要 TSSOP-14（PW 后缀）**，焊盘不匹配。
2. **10µF 电容**：C7 是 10 微法（不是 10 纳法），0805、25V X5R。
3. **电阻精度**：全部按 1% 买（0805，1/8W）。
4. **IDC 简牛座**：2.54mm 双排，2x10 买 2 个、2x18 买 1 个；如果需要线缆防脱落，选带锁扣款。
5. **建议备件余量**：电阻电容按 **+20%** 买（4.7k/330/10k 各买 20 个），芯片各多买 1 个。
6. **不采购**：测试点 TP1-TP51（板上是焊盘）、安装孔 H1-H4（只是孔）。
7. **JP1 与 RCT1 二选一**：JP1（排针跳线）和 RCT1（0Ω）是互斥配置，两种都买、装配只装一个。

## 三、按类别的淘宝下单建议

- **电阻电容**：搜 `0805 贴片电阻包` 或直接按上面搜索词买，单价几分钱一个，建议每种买 50 只装。
- **逻辑芯片**：搜全型号（如 `SN74LVC07ADR`），认准 **SOIC-14** 封装，TI/其他品牌均可。
- **排针/简牛**：搜 `2.54 简牛座`，注意双排（2x10 是 20 脚，2x18 是 36 脚）。

## 四、数量汇总（便于下单核对）

| 类别 | 种类 | 总数量 |
|---|---|---|
| 陶瓷电容 | 2 种 | 7 只 |
| 贴片电阻 | 4 种 | 49 只 |
| 逻辑芯片 | 2 种 | 6 只 |
| 排针/简牛 | 3 种 | 5 只 |
| **合计** | **11 种** | **67 只** |
