250888/fpga2026-42161/pcb/eda_fab/BOM_xunji_fe16_2026_10_17.csv

Supplier | Supplier Part | Manufacturer | Manufacturer Part | Value | Footprint | Designator | Comment | Quantity | No.
LCSC | C28233 |  |  |  | fe16:R_0805_2012Metric | C1,C2,C3,C4,C5,C6 | 100nF | 6 | 1
LCSC | C15850 |  |  |  | fe16:R_0805_2012Metric | C7 | 10uF | 1 | 2
LCSC | C9900010030 |  |  |  | fe16:PinHeader_1x02_P2.54mm | EXT1,JP1 | HDR-1x2 | 2 | 3
LCSC | C55160413 |  |  |  | fe16:IDC-Header_2x18_P2.54mm | J5 | IDC-2x18 | 1 | 4
LCSC | C9900016201 |  |  |  | fe16:IDC-Header_2x10_P2.54mm | JA,JB | IDC-2x10 | 2 | 5
LCSC | C17477 |  |  |  | fe16:R_0805_2012Metric | RCT1 | 0 | 1 | 6
LCSC | C17673 |  |  |  | fe16:R_0805_2012Metric | RP1,RP2,RP3,RP4,RP5,RP6,RP7,RP8,RP9,RP10,RP11,RP12,RP13,RP14,RP15,RP16 | 4.7k | 16 | 7
LCSC | C17630 |  |  |  | fe16:R_0805_2012Metric | RS1,RS2,RS3,RS4,RS5,RS6,RS7,RS8,RS9,RS10,RS11,RS12,RS13,RS14,RS15,RS16 | 330 | 16 | 8
LCSC | C17414 |  |  |  | fe16:R_0805_2012Metric | RU1,RU2,RU3,RU4,RU5,RU6,RU7,RU8,RU9,RU10,RU11,RU12,RU13,RU14,RU15,RU16 | 10k | 16 | 9
LCSC | C7659 |  |  |  | fe16:SOIC-14_3.9x8.7mm_P1.27mm | U1,U2,U3 | SN74LVC07A | 3 | 10
LCSC | C133541 |  |  |  | fe16:SOIC-14_3.9x8.7mm_P1.27mm | U4,U5,U6 | SN74LVC14A | 3 | 11
