250888/fpga2026-42161/pcb/frontend16/BOM_fe16.csv

Reference | Value | Footprint | Description | Qty
RS1 RS2 RS3 RS4 RS5 RS6 RS7 RS8 RS9 RS10 RS11 RS12 RS13 RS14 RS15 RS16 | 330 | R_Axial_P2.54mm_Vertical | A端串联保护(直插立式) | 16
RU1 RU2 RU3 RU4 RU5 RU6 RU7 RU8 RU9 RU10 RU11 RU12 RU13 RU14 RU15 RU16 | 10k | R_Axial_P2.54mm_Vertical | LVC07输入安全上拉(直插立式) | 16
RP1 RP2 RP3 RP4 RP5 RP6 RP7 RP8 RP9 RP10 RP11 RP12 RP13 RP14 RP15 RP16 | 4.7k | R_Axial_P2.54mm_Vertical | B端上拉Rp可替换(直插立式) | 16
C1 | 100nF | C_0805_2012Metric | U1去耦 | 1
C2 | 100nF | C_0805_2012Metric | U2去耦 | 1
C3 | 100nF | C_0805_2012Metric | U3去耦 | 1
C4 | 100nF | C_0805_2012Metric | U4去耦 | 1
C5 | 100nF | C_0805_2012Metric | U5去耦 | 1
C6 | 100nF | C_0805_2012Metric | U6去耦 | 1
C7 | 10uF | C_0805_2012Metric | J5入口总旁路 | 1
RCT1 | 0 | R_Axial_P2.54mm_Vertical | 整板电流断点(测流取下,直插立式) | 1
JP1 | HDR-1x2 | PinHeader_1x02_P2.54mm | EXT供电选择,与RCT1互斥 | 1
EXT1 | HDR-1x2 | PinHeader_1x02_P2.54mm | 外部3.3V入口(仅3V3,禁5V) | 1
U1 U2 U3 | SN74LVC07A | SOIC-14_3.9x8.7mm_P1.27mm | 6路开漏缓冲 | 3
U4 U5 U6 | SN74LVC14A | SOIC-14_3.9x8.7mm_P1.27mm | 6路施密特反相 | 3
J5 | IDC-2x18 | IDC-Header_2x18_P2.54mm | J5转接36Pin | 1
JA | IDC-2x10 | IDC-Header_2x10_P2.54mm | A端DUT 20Pin | 1
JB | IDC-2x10 | IDC-Header_2x10_P2.54mm | B端DUT 20Pin | 1
TP1 TP2 TP3 TP4 TP5 TP6 TP7 TP8 TP9 TP10 TP11 TP12 TP13 TP14 TP15 TP16 TP17 TP18 TP19 TP20 TP21 TP22 TP23 TP24 TP25 TP26 TP27 TP28 TP29 TP30 TP31 TP32 TP33 TP34 TP35 TP36 TP37 TP38 TP39 TP40 TP41 TP42 TP43 TP44 TP45 TP46 TP47 TP48 TP49 TP50 TP51 | TestPoint | TestPoint_THTPad_1.7mm |  | 51
H1 H2 H3 H4 | MountingHole | MountingHole_3.2mm |  | 4
