250888/fpga2026-42161/doc/case/out/xunji_case_asm.step

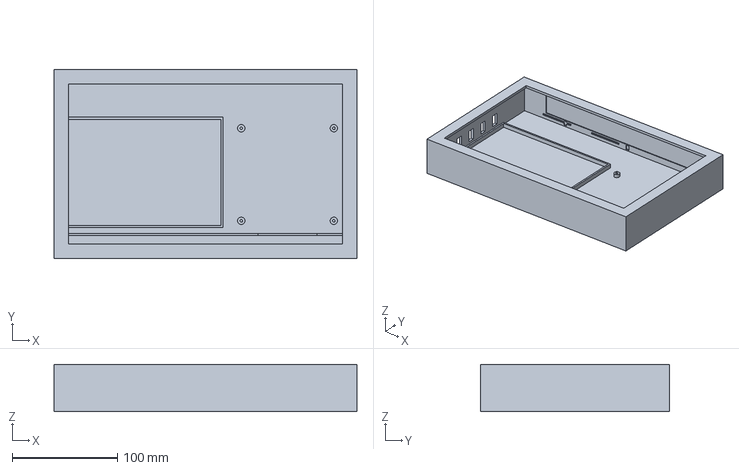
[picture p32: CAD file, 2026-11-04]
doc/case/out/xunji_case_asm.step
288.0 x 180.0 x 45.0 mm
