250888/fpga2026-42161/doc/case/out/xunji_case_lid.step

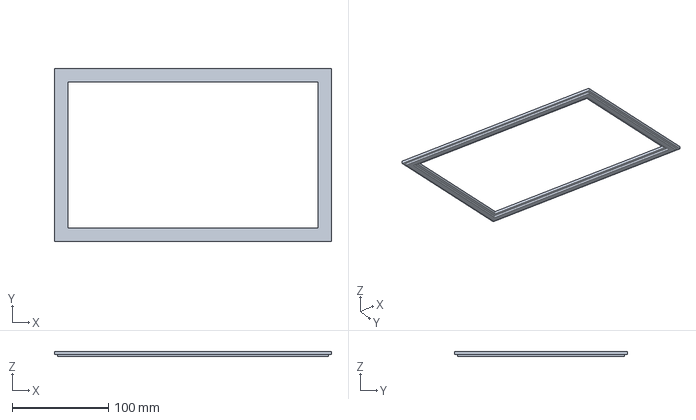
[picture p33: CAD file, 2026-11-04]
doc/case/out/xunji_case_lid.step
288.0 x 180.0 x 5.00 mm
