250888/fpga2026-42161/doc/case/out/xunji_case_base.step

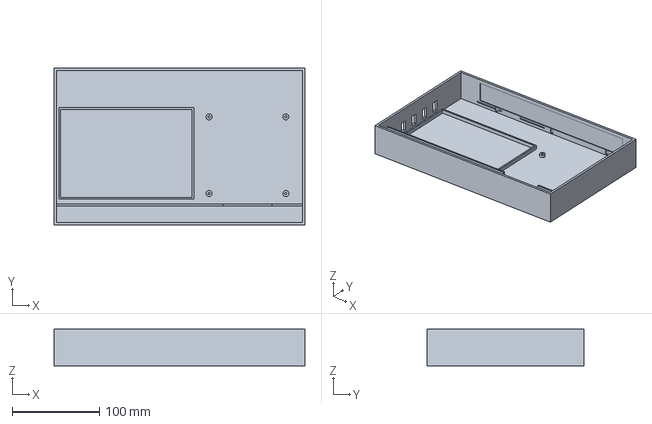
[picture p34: CAD file, 2026-11-04]
doc/case/out/xunji_case_base.step
288.0 x 180.0 x 42.0 mm
