250888/fpga2026-42161/(list of files, cad)

Other CAD files:
doc/case/out/xunji_case_asm.stl
doc/case/out/xunji_case_base.stl
doc/case/out/xunji_case_lid.stl
