250888/fpga2026-42161/skill/hw-bringup-pitfalls.md

# Skill 1 — FPGA 外扩板通道级排障清单

## 适用场景

自制的 FPGA 外扩板上，**部分通道**工作不正常：读数对不上、某几路永远「不通」、
或者故障通道每次上电都换一个。典型于手工焊接的多通道模拟前端（缓冲器 / 上拉 / 施密特触发器）。

不适用：整块板完全不工作（先查电源与配置），或纯数字逻辑内部错误。

## 核心判据（按顺序用，能用前一条就不要用后一条）

### 判据 A：故障通道是否随插拔/重焊**移动**

| 现象 | 结论 |
|---|---|
| 故障通道跟着**线束/连接器**走，或每次重插都换位置 | **接触不良**（线、端子、排针焊点） |
| 故障通道**固定不变**，多次重烧、重插、换线还是同一路 | **板级固定故障**（器件、走线、漏焊） |

> 这是最高优先级判据。它把「一堆可能性」一刀切成两类，省掉大量猜测。

### 判据 B：用**全局信号**反推**整段链路**健康

找一路在空闲态一定有确定电平的信号（本项目是每个通道的回采线），如果它的位掩码全为 0，
说明**整段回采链路**（上拉、整形芯片、到 FPGA 的走线）全部健康。
这样可以把排查范围直接砍掉一半，不必逐路验证。

### 判据 C：**焊盘连通 ≠ 芯片脚连通**

蜂鸣档测到的是**焊盘**。SOIC/TSSOP 的引脚与焊盘之间虚焊时，蜂鸣照样响。
暴露虚焊的方法是量**同一网段两端的电压差**：一端被驱动到 3.3 V，另一端只有 0.3 V，
说明中间那段（引脚-焊盘）没接上。

### 判据 D：**量电源轨对地必须先断开板间连接**

板上若有 0 Ω 电流断点或直连排线把两块板的同一电源网连起来，
量到的电阻是**两块板并联**的结果，会把另一块板的正常阻抗当成短路。
本项目曾把「EGO1 的 3.3 V 轨阻抗 3.8 kΩ」误判成外扩板漏电，绕了很久。

### 判据 E：**局部补焊会祸及邻脚**

0.65 mm 脚距的 SOIC，只烙两三个脚会把热量传到邻脚、把原本好的焊点烘软位移。
**要拖就整排一次拖完**，不要「只补坏的」。

### 判据 F：**分立电阻漏焊，拖芯片引脚永远修不好**

串阻 / 上拉漏焊导致的通路断开，症状与芯片坏一模一样。
先量「芯片输出脚 ↔ 测试点」是否为预期阻值（本项目的串阻 330 Ω），再怀疑芯片。

## 使用方法

1. 先按 **A** 判断是接触不良还是板级故障
2. 按 **B** 用全局信号把范围砍一半
3. 剩下的逐段用**通断表**定位：驱动源 → 串阻 → 测试点 → 线束 → 上拉 → 整形 → FPGA
4. 每段都有**明确的期望值**（0 Ω / 330 Ω / 10 kΩ / 开路），对不上就是那一段
5. 补焊时遵守 **E**；补完先量 **C** 的电压差，不要只看蜂鸣

## 失效条件

- 芯片**内部**门损坏（输入输出都焊好、外部阻值都对但就是不工作）→ 本清单只能帮你排除到这一步，结论是换件
- 故障是**时序/采样**问题而非连通性问题 → 转去查采样窗口与滤波参数
- 板上有**多层板内层断线** → 外部通断测不出来，只能飞线

## 已验证效果

本项目 16 通道外扩板，从「只有 5 路能通」收敛到「16/16 全通」，
其中 11 路故障全部由本清单定位：
- U1 整颗方向/焊点问题 → 影响 6 路
- 一颗 330 Ω 串阻漏焊 → 影响 1 路
- 两颗缓冲器芯片内部门损坏 → 影响 3 路
- 连接器接触不良 → 影响其余

## 提炼来源

本项目开发后期连续 6 轮排障的复盘：
每一次错误假设（漏电误判、虚焊与断线混淆、局部补焊制造新故障）都对应上面一条判据。
```
