250888/fpga2026-42161/(list of files, drawings)

Other design files:
pcb/frontend16/xunji_fe16.dsn
