250888/fpga2026-42161/pcb/frontend16/xunji_fe16.kicad_pcb

## KiCad design pcb/frontend16/xunji_fe16.kicad_pcb (2026-11-04)

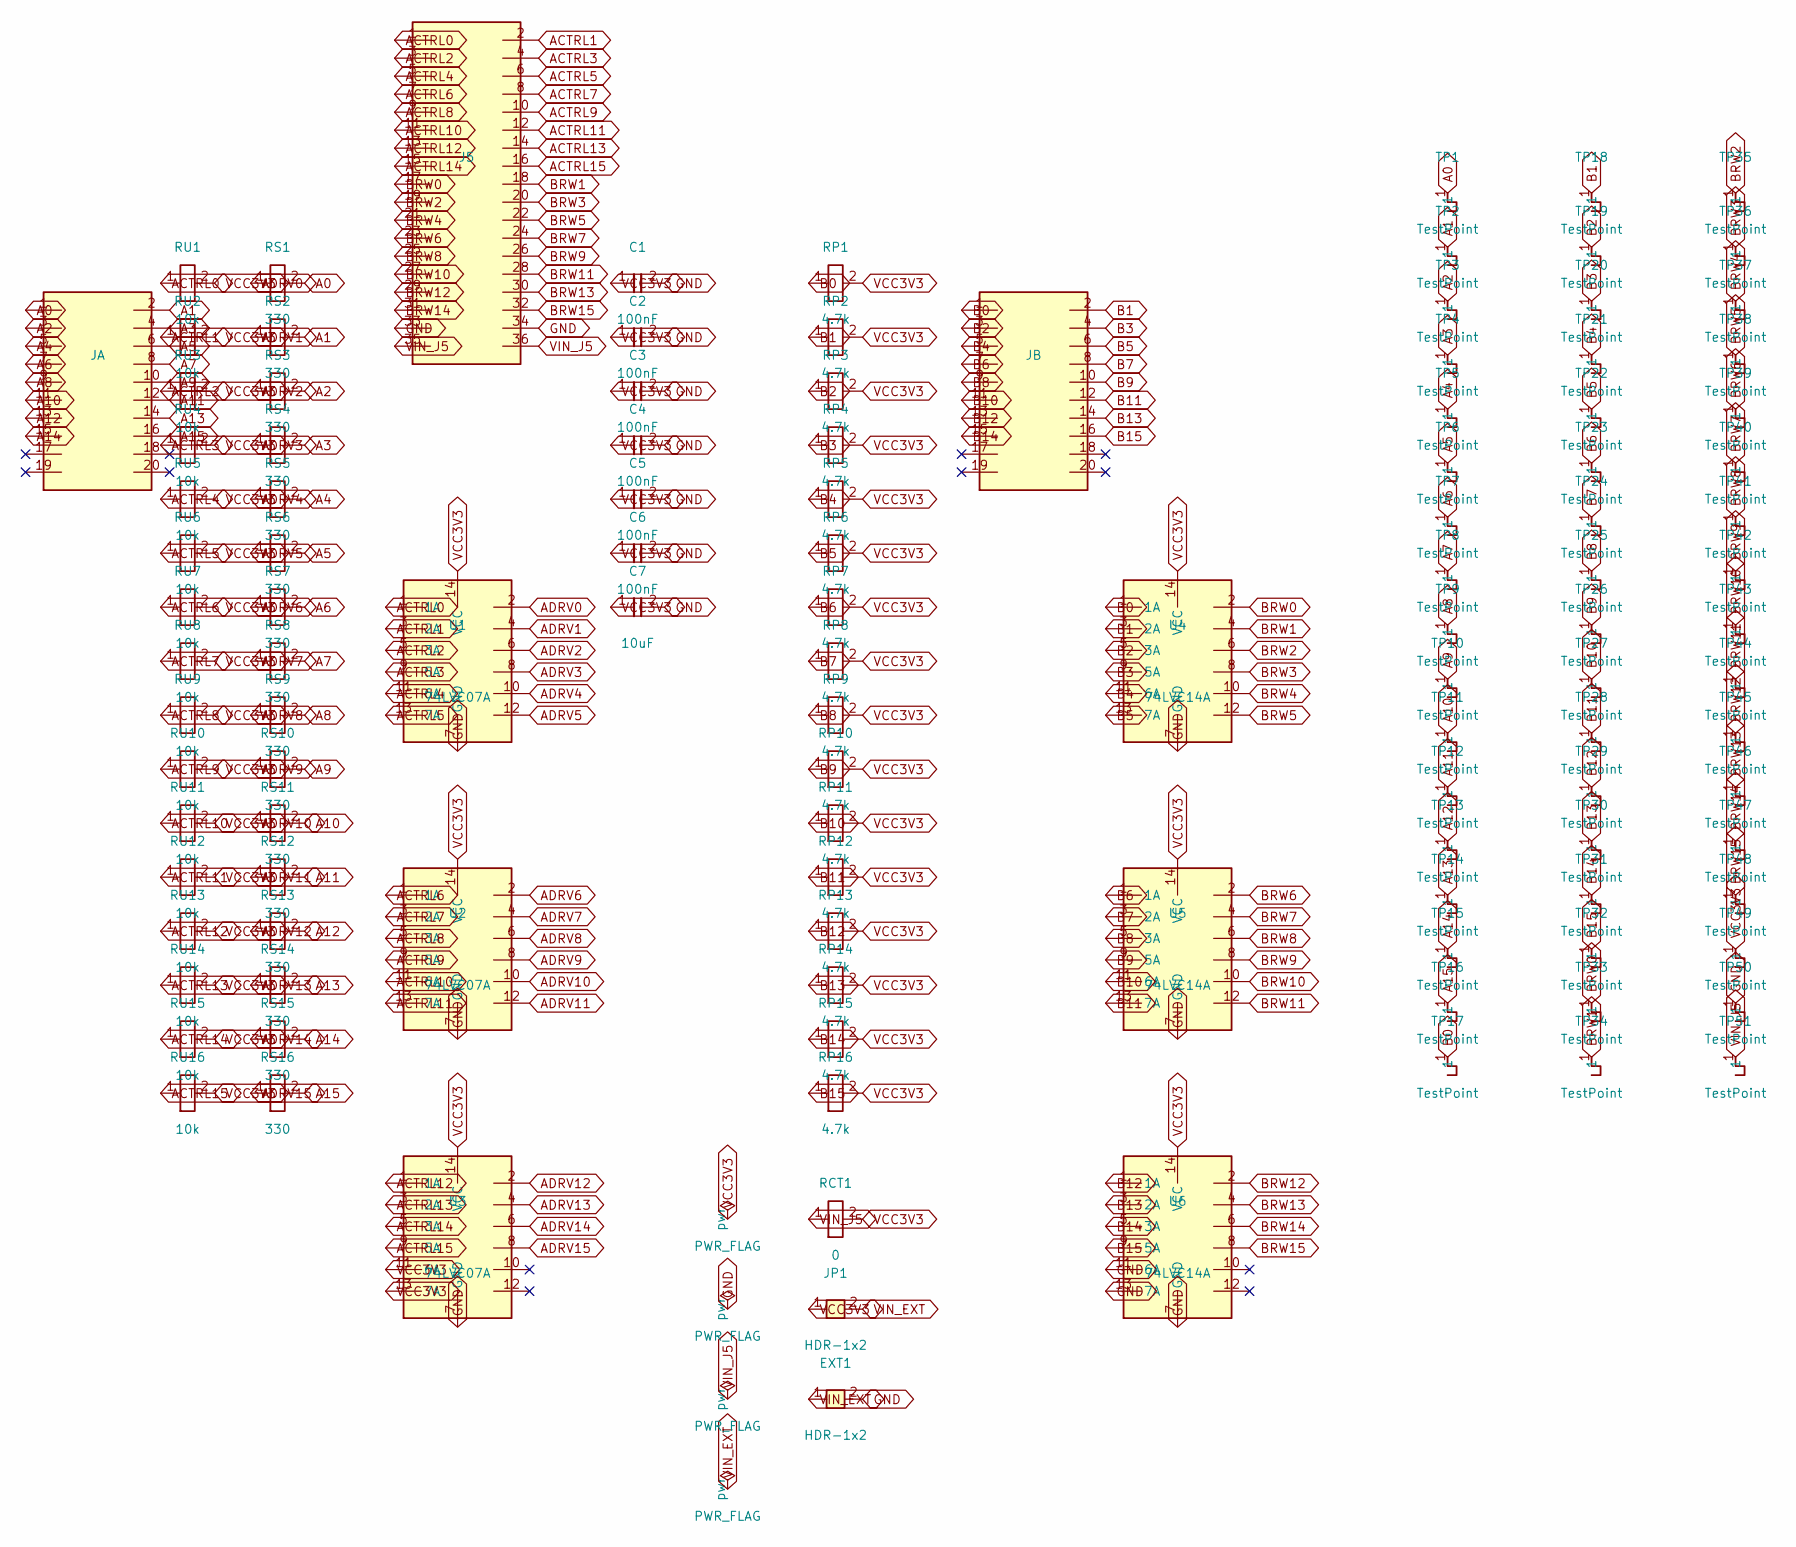
[picture p35: schematic xunji_fe16.kicad_sch, XunJi FE-16 16路前端]

Parts:
C1, C2, C3, C4, C5, C6: 100nF
C7: 10uF
EXT1: HDR-1x2
J5: (no value)
JA: (no value)
JB: (no value)
JP1: HDR-1x2
RCT1: 0
RP1, RP2, RP3, RP4, RP5, RP6, RP7, RP8, RP9, RP10, RP11, RP12, RP13, RP14, RP15, RP16: 4.7k
RS1, RS2, RS3, RS4, RS5, RS6, RS7, RS8, RS9, RS10, RS11, RS12, RS13, RS14, RS15, RS16: 330
RU1, RU2, RU3, RU4, RU5, RU6, RU7, RU8, RU9, RU10, RU11, RU12, RU13, RU14, RU15, RU16: 10k
TP1, TP2, TP3, TP4, TP5, TP6, TP7, TP8, TP9, TP10, TP11, TP12, TP13, TP14, TP15, TP16, TP17, TP18, TP19, TP20, TP21, TP22, TP23, TP24, TP25, TP26, TP27, TP28, TP29, TP30, TP31, TP32, TP33, TP34, TP35, TP36, TP37, TP38, TP39, TP40, TP41, TP42, TP43, TP44, TP45, TP46, TP47, TP48, TP49, TP50, TP51: TestPoint
U1, U2, U3: 74LVC07A
U4, U5, U6: 74LVC14A

Connections:
A0: JA.1, RS1.2, TP1.1
A1: JA.2, RS2.2, TP2.1
A2: JA.3, RS3.2, TP3.1
A3: JA.4, RS4.2, TP4.1
A4: JA.5, RS5.2, TP5.1
A5: JA.6, RS6.2, TP6.1
A6: JA.7, RS7.2, TP7.1
A7: JA.8, RS8.2, TP8.1
A8: JA.9, RS9.2, TP9.1
A9: JA.10, RS10.2, TP10.1
A10: JA.11, RS11.2, TP11.1
A11: JA.12, RS12.2, TP12.1
A12: JA.13, RS13.2, TP13.1
A13: JA.14, RS14.2, TP14.1
A14: JA.15, RS15.2, TP15.1
A15: JA.16, RS16.2, TP16.1
ACTRL0: J5.1, RU1.1, U1.1 (1A)
ACTRL1: J5.2, RU2.1, U1.3 (2A)
ACTRL2: J5.3, RU3.1, U1.5 (3A)
ACTRL3: J5.4, RU4.1, U1.9 (5A)
ACTRL4: J5.5, RU5.1, U1.11 (6A)
ACTRL5: J5.6, RU6.1, U1.13 (7A)
ACTRL6: J5.7, RU7.1, U2.1 (1A)
ACTRL7: J5.8, RU8.1, U2.3 (2A)
ACTRL8: J5.9, RU9.1, U2.5 (3A)
ACTRL9: J5.10, RU10.1, U2.9 (5A)
ACTRL10: J5.11, RU11.1, U2.11 (6A)
ACTRL11: J5.12, RU12.1, U2.13 (7A)
ACTRL12: J5.13, RU13.1, U3.1 (1A)
ACTRL13: J5.14, RU14.1, U3.3 (2A)
ACTRL14: J5.15, RU15.1, U3.5 (3A)
ACTRL15: J5.16, RU16.1, U3.9 (5A)
ADRV0: RS1.1, U1.2
ADRV1: RS2.1, U1.4
ADRV2: RS3.1, U1.6
ADRV3: RS4.1, U1.8
ADRV4: RS5.1, U1.10
ADRV5: RS6.1, U1.12
ADRV6: RS7.1, U2.2
ADRV7: RS8.1, U2.4
ADRV8: RS9.1, U2.6
ADRV9: RS10.1, U2.8
ADRV10: RS11.1, U2.10
ADRV11: RS12.1, U2.12
ADRV12: RS13.1, U3.2
ADRV13: RS14.1, U3.4
ADRV14: RS15.1, U3.6
ADRV15: RS16.1, U3.8
B0: JB.1, RP1.1, TP17.1, U4.1 (1A)
B1: JB.2, RP2.1, TP18.1, U4.3 (2A)
B2: JB.3, RP3.1, TP19.1, U4.5 (3A)
B3: JB.4, RP4.1, TP20.1, U4.9 (5A)
B4: JB.5, RP5.1, TP21.1, U4.11 (6A)
B5: JB.6, RP6.1, TP22.1, U4.13 (7A)
B6: JB.7, RP7.1, TP23.1, U5.1 (1A)
B7: JB.8, RP8.1, TP24.1, U5.3 (2A)
B8: JB.9, RP9.1, TP25.1, U5.5 (3A)
B9: JB.10, RP10.1, TP26.1, U5.9 (5A)
B10: JB.11, RP11.1, TP27.1, U5.11 (6A)
B11: JB.12, RP12.1, TP28.1, U5.13 (7A)
B12: JB.13, RP13.1, TP29.1, U6.1 (1A)
B13: JB.14, RP14.1, TP30.1, U6.3 (2A)
B14: JB.15, RP15.1, TP31.1, U6.5 (3A)
B15: JB.16, RP16.1, TP32.1, U6.9 (5A)
BRW0: J5.17, TP33.1, U4.2
BRW1: J5.18, TP34.1, U4.4
BRW2: J5.19, TP35.1, U4.6
BRW3: J5.20, TP36.1, U4.8
BRW4: J5.21, TP37.1, U4.10
BRW5: J5.22, TP38.1, U4.12
BRW6: J5.23, TP39.1, U5.2
BRW7: J5.24, TP40.1, U5.4
BRW8: J5.25, TP41.1, U5.6
BRW9: J5.26, TP42.1, U5.8
BRW10: J5.27, TP43.1, U5.10
BRW11: J5.28, TP44.1, U5.12
BRW12: J5.29, TP45.1, U6.2
BRW13: J5.30, TP46.1, U6.4
BRW14: J5.31, TP47.1, U6.6
BRW15: J5.32, TP48.1, U6.8
GND: C1.2, C2.2, C3.2, C4.2, C5.2, C6.2, C7.2, EXT1.2, J5.33, J5.34, TP50.1, U1.7 (GND), U2.7 (GND), U3.7 (GND), U4.7 (GND), U5.7 (GND), U6.7 (GND), U6.11 (6A), U6.13 (7A)
VCC3V3: C1.1, C2.1, C3.1, C4.1, C5.1, C6.1, C7.1, JP1.1, RCT1.2, RP1.2, RP2.2, RP3.2, RP4.2, RP5.2, RP6.2, RP7.2, RP8.2, RP9.2, RP10.2, RP11.2, RP12.2, RP13.2, RP14.2, RP15.2, RP16.2, RU1.2, RU2.2, RU3.2, RU4.2, RU5.2, RU6.2, RU7.2, RU8.2, RU9.2, RU10.2, RU11.2, RU12.2, RU13.2, RU14.2, RU15.2, RU16.2, TP49.1, U1.14 (VCC), U2.14 (VCC), U3.11 (6A), U3.13 (7A), U3.14 (VCC), U4.14 (VCC), U5.14 (VCC), U6.14 (VCC)
VIN_EXT: EXT1.1, JP1.2
VIN_J5: J5.35, J5.36, RCT1.1, TP51.1

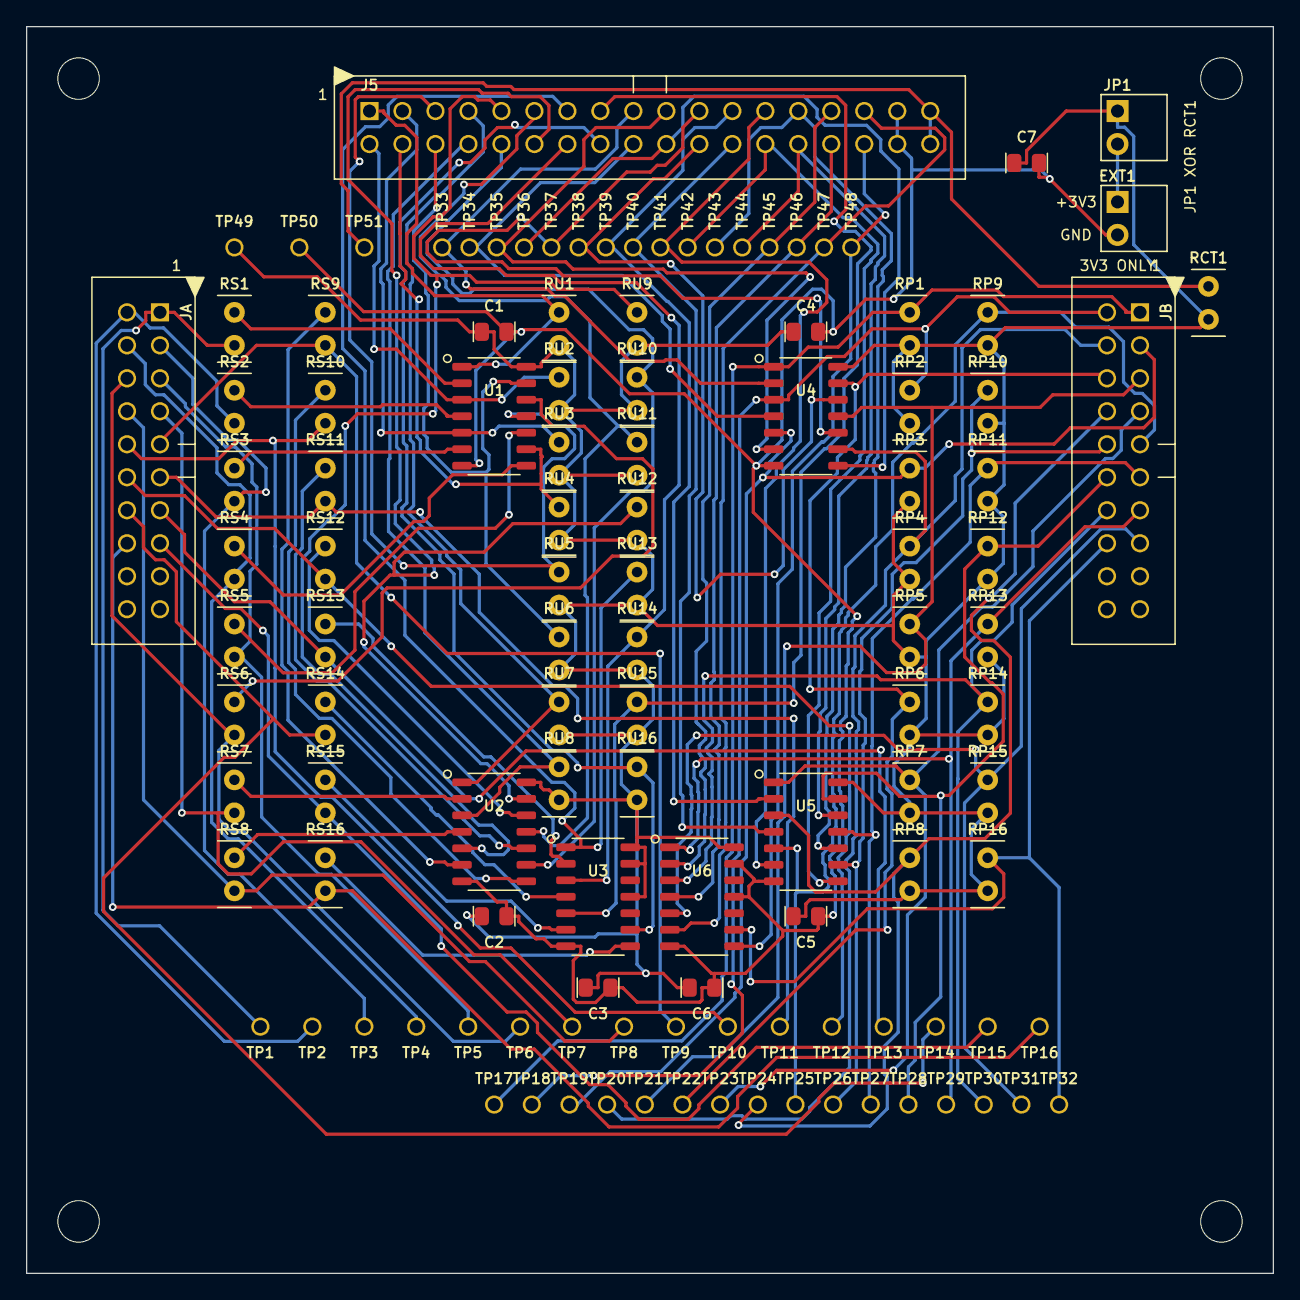
[picture p36: board xunji_fe16.kicad_pcb from above]

Board: 2 copper layers, 96.0 x 96.0 mm, 122 parts (0 on the bottom side), 84 nets.

Other parts of the board:
H1, H2, H3, H4: MountingHole; MountingHole_3.2mm
